JC-Project-IDEA/2025-26-Student-Workshop/Slides/JC Project IDEA - 202526 Software Installation (Windows)-20250909.pdf

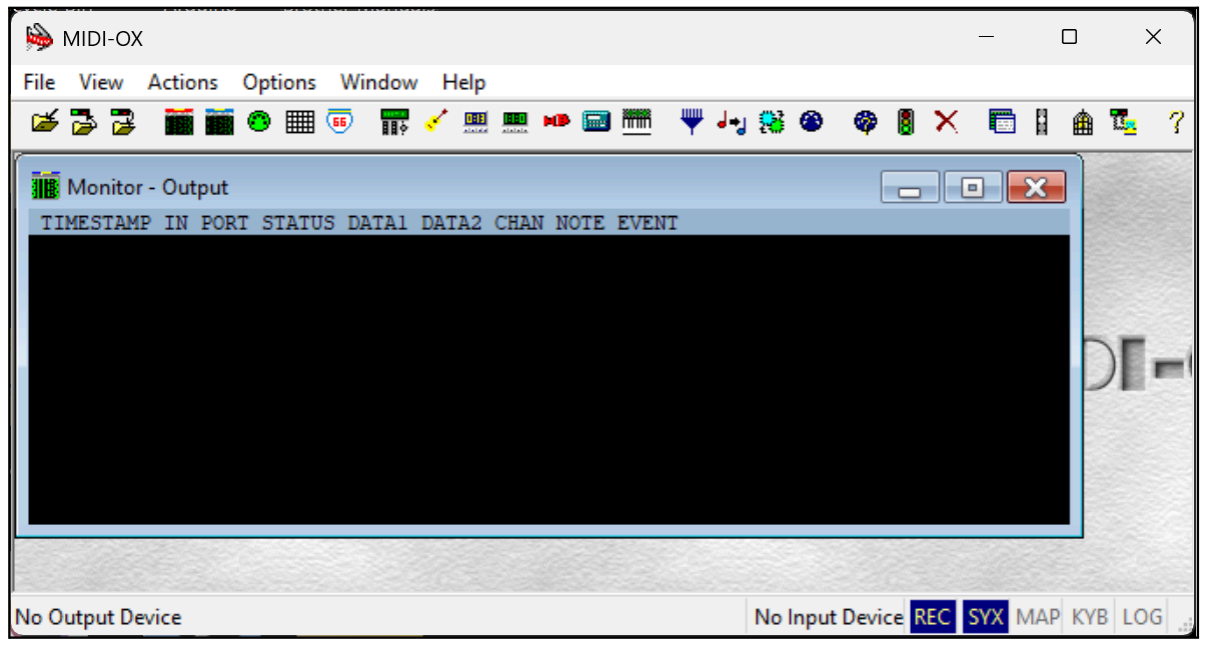
[picture p79: figure]
