JC-Project-IDEA/2025-26-Student-Workshop/Slides/Assembly Guide for Workshops_20251024.pdf

# Jockey Club Project IDEA

# Inclusive Digital and Experimental Art

# 賽馬會科藝共融計劃

# Assembly Guide

### 組裝指南

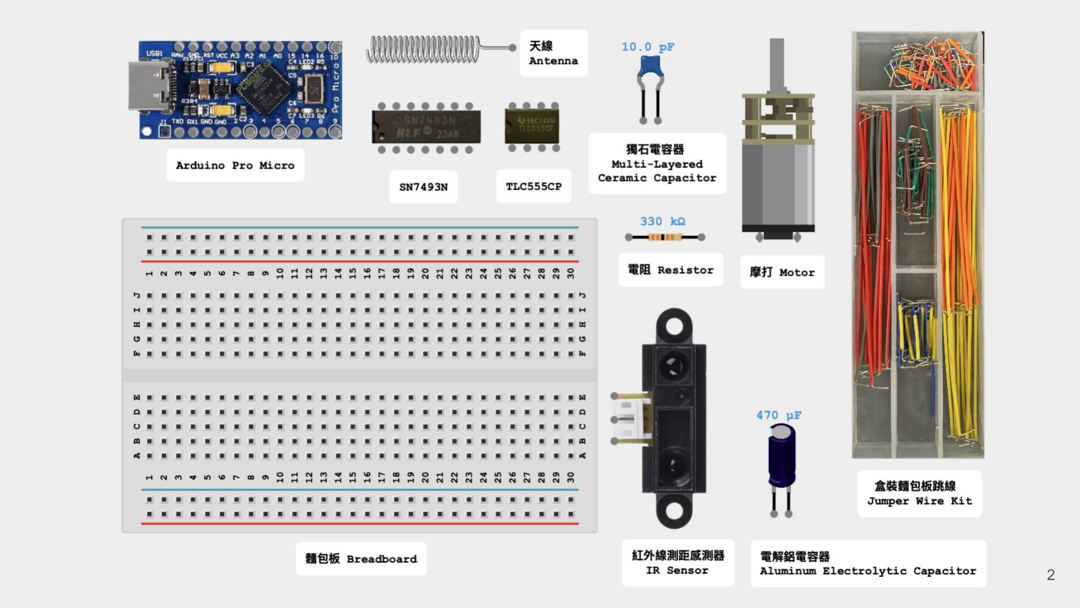
[picture p1: page 2]

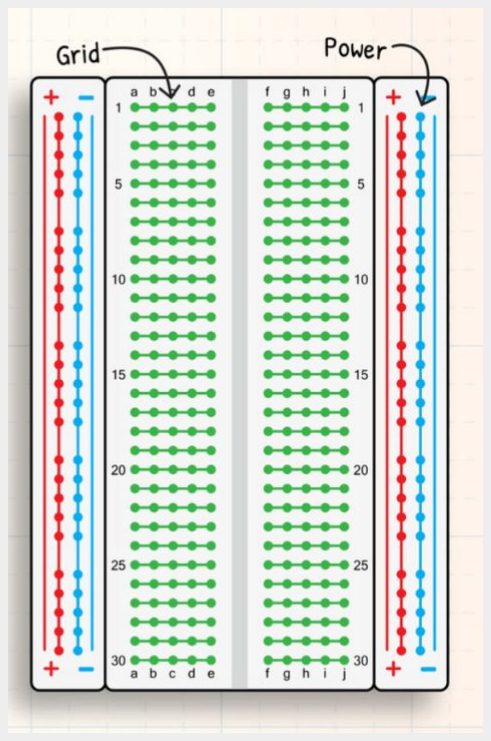
[picture p2: figure]
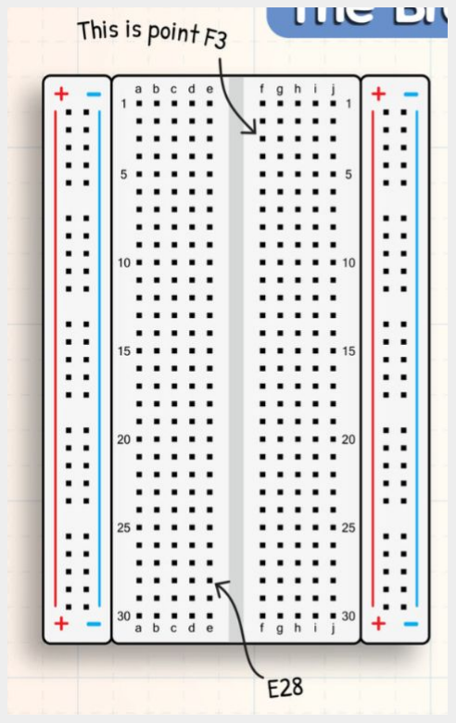
[picture p3: figure]

麵 包 板（ Breadboard）是 一 種 用 於 電 子 電 路 原型設計的免 焊接工具，它允許使用者插入和
拔出電子元件及導線。

麵包板中央的插孔組（通常為每組 5個孔相連）
用於連接電阻、 LED 等電子元件和跳線，以形
成實驗電路。麵包板兩側的兩條長條形插孔（通
常標有「 +」和「 -」紅藍線）用作電源供應，可為整 個電路提供正極和接地。

https://cdn.flipsnack.com/widget/v2/widget.html?hash=hil43imxu3

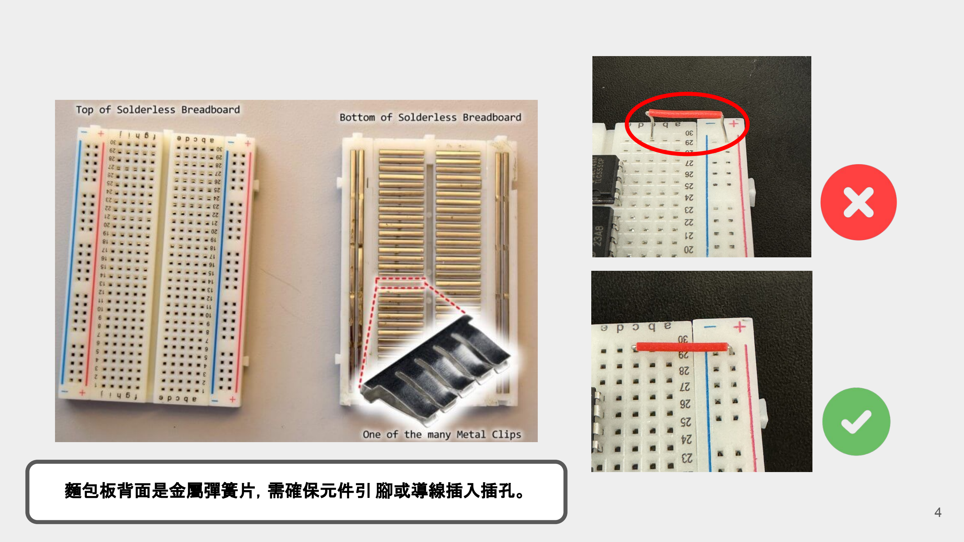
[picture p4: page 4]

麵包板背面是金屬彈簧片，需確保元件引

腳或導線插入插孔。

## 導電五金材料：

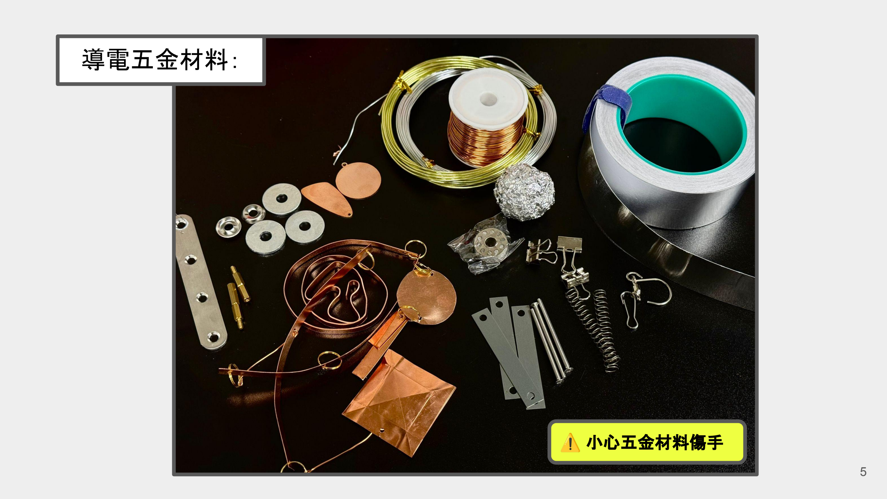
[picture p5: page 5]

⚠ 小心五金材料傷手

# 開始組裝！

# tinyurl.com/SWS2526

## 步驟 1：用跳線連接“正極”和“負極”

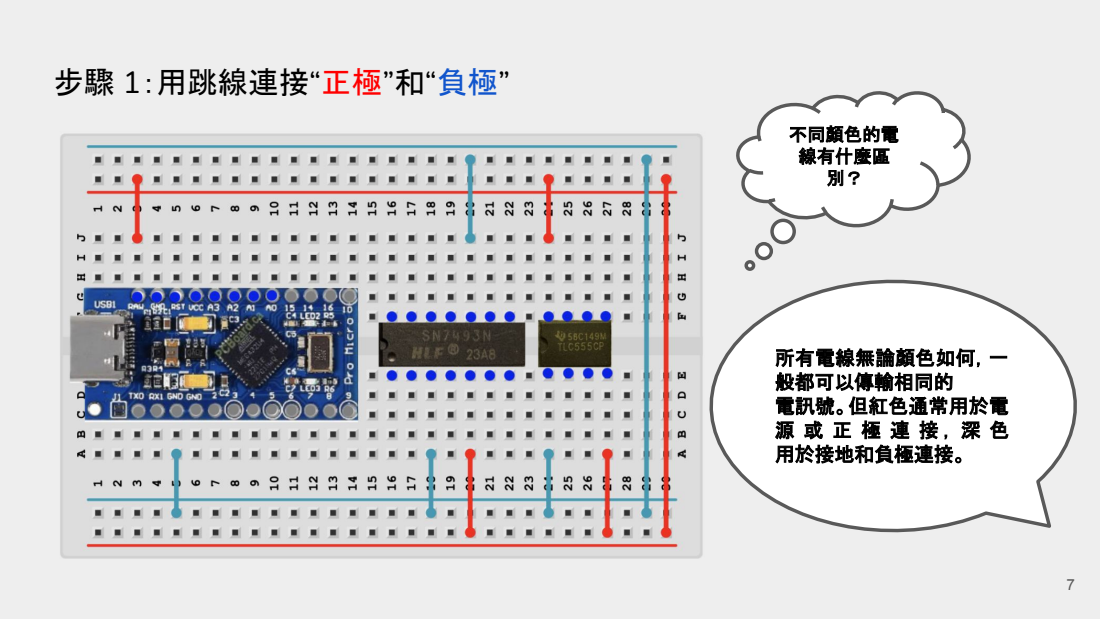
[picture p6: page 7]
不同顏色的電 線有什麼區 別？; 所有電線無論顏色如何，一 般都可以傳輸相同的 電訊號。但紅色通常用於電 源 或 正 極 連 接 ， 深 色 用於接地和負極連接。

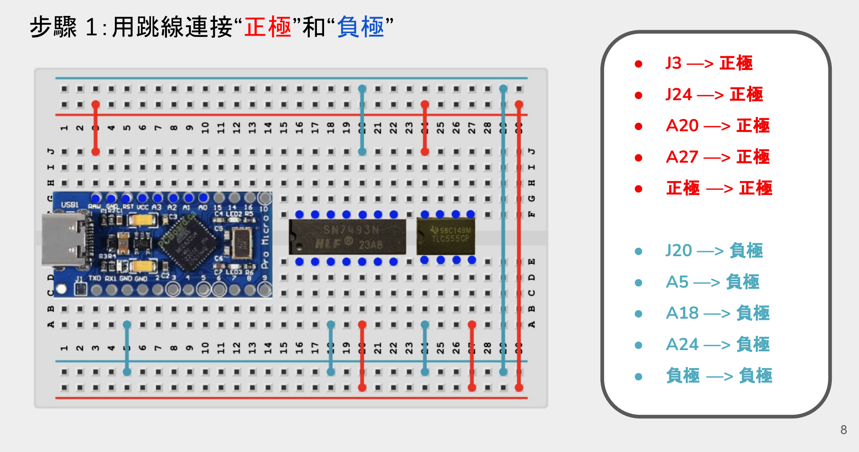
[picture p7: figure]
步驟 1：用跳線連接“正極”和“負極”

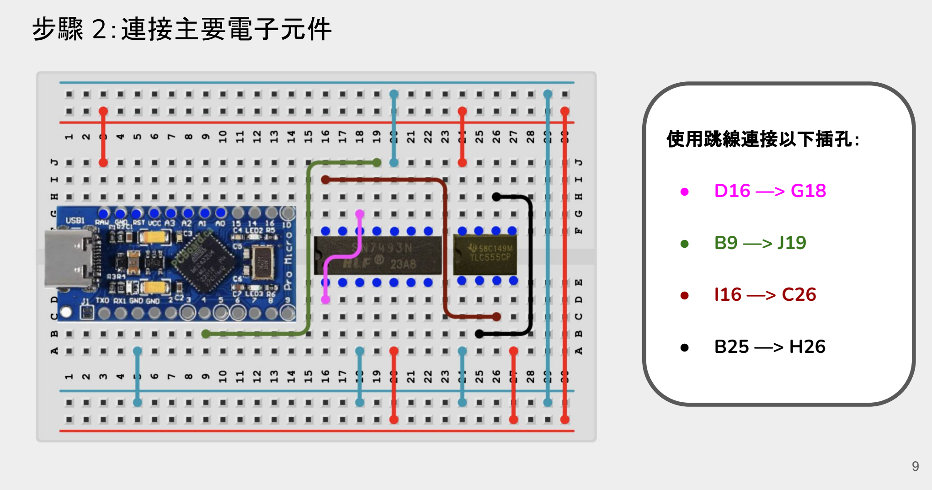
[picture p8: figure]
步驟 2：連接主要電子元件; 使用跳線連接以下插孔：

## 步驟 3：連接電容器、電阻和紅外感測器

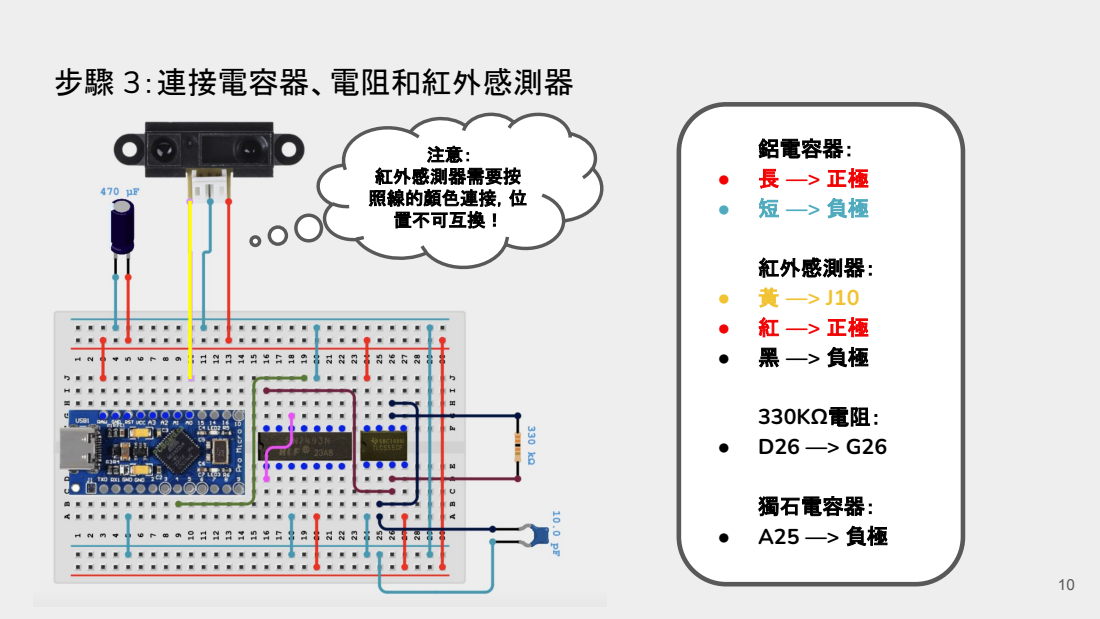
[picture p9: page 10]
鋁電容器： ● 長 —> 正極 ● 短 —> 負極; 紅外感測器： ● 黃 —> J10 ● 紅 —> 正極 ● 黑 —> 負極; 330KΩ電阻： ● D26 —> G26; 獨石電容器： ● A25 —> 負極; 注意： 紅外感測器需要按 照線的顏色連接，位 置不可互換！

## 步驟 3：連接電容器、電阻和紅外感測器

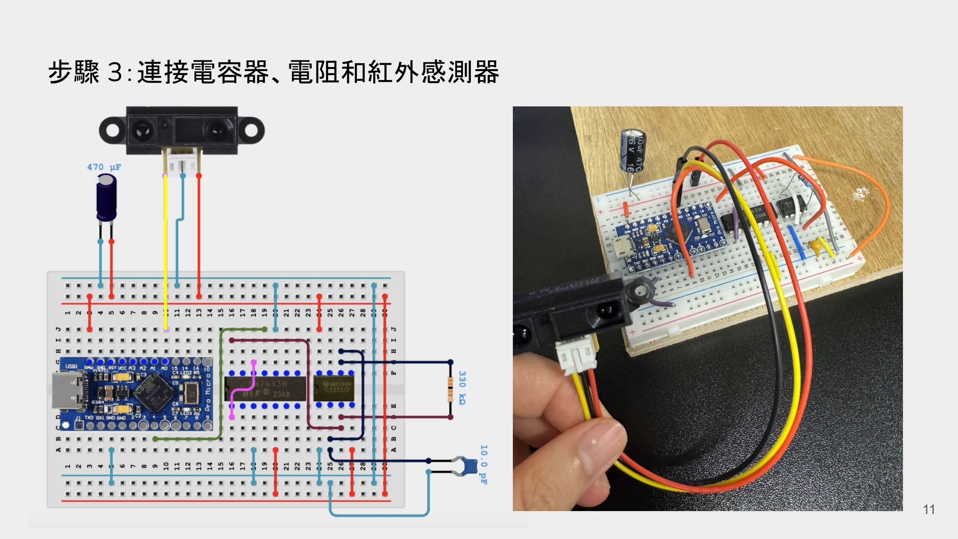
[picture p10: page 11]

## 步驟 4：使用砂紙去除銅線上的絕緣層

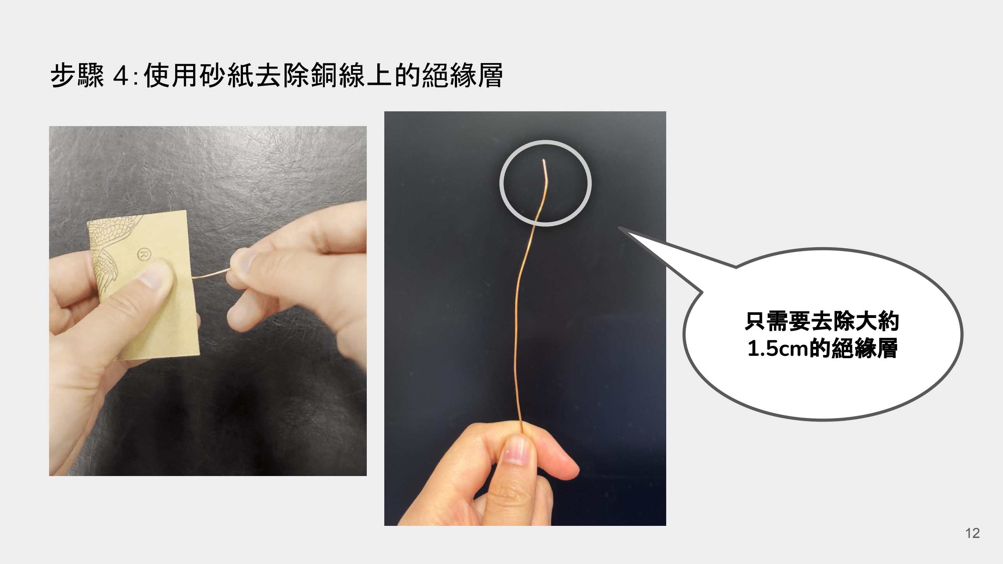
[picture p11: page 12]

只需要去除大約

## 1.5cm的絕緣層

## 步驟 5：將磨好的銅線插入麵包版 J26 位置，作為特雷門琴的天線

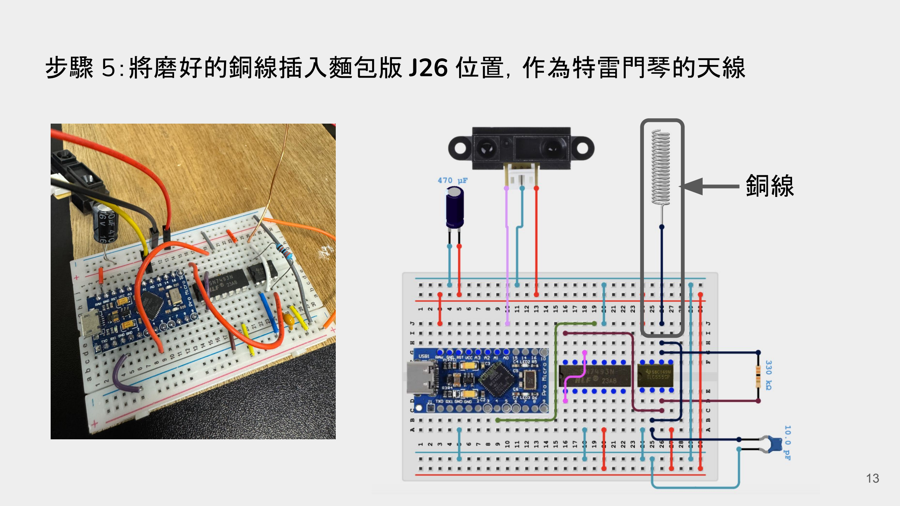
[picture p12: page 13]

銅線

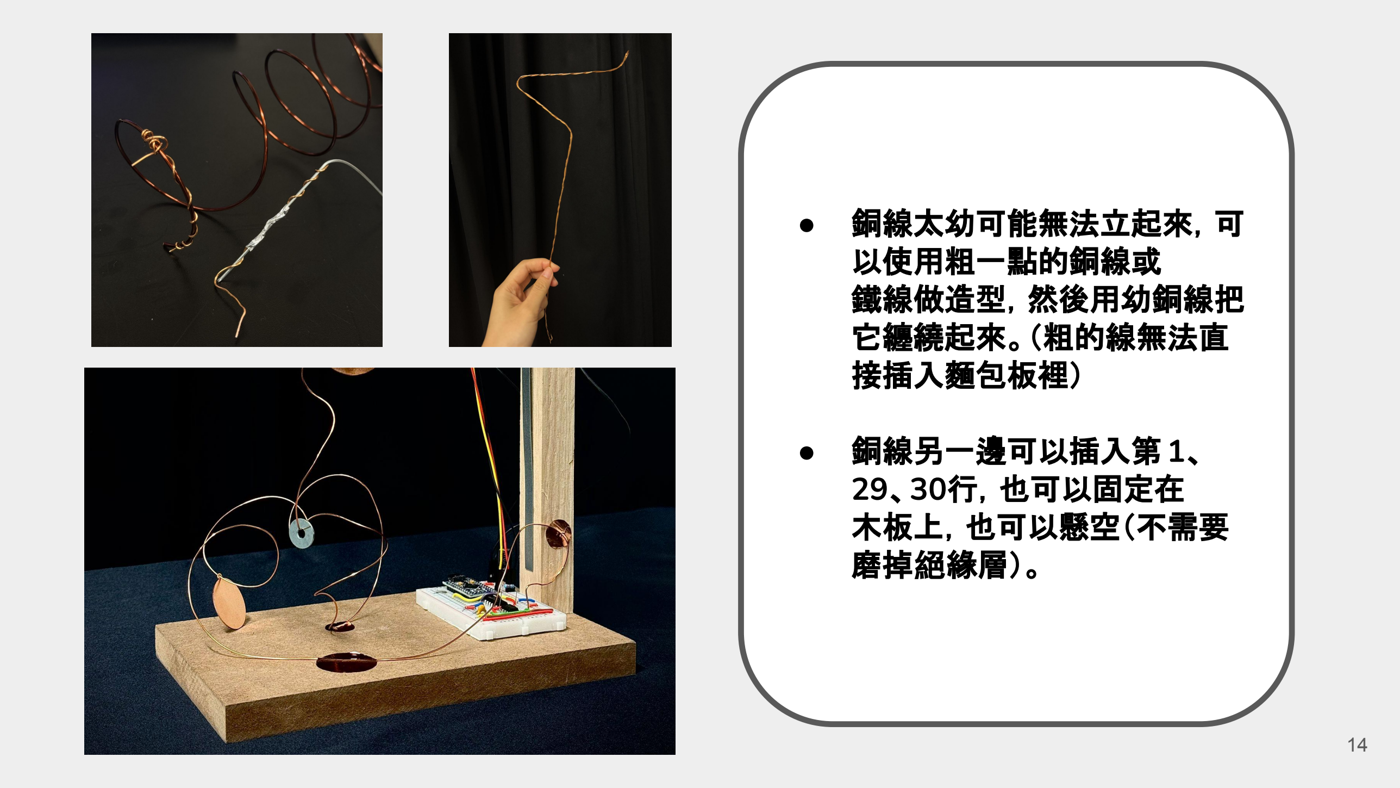
[picture p13: page 14]

- 銅線太幼可能無法立起來，可
以使用粗一點的銅線或
鐵線做造型，然後用幼銅線把
它纏繞起來。（粗的線無法直
接插入麵包板裡）
- 銅線另一邊可以插入第1、
29、30行，也可以固定在
木板上，也可以懸空（不需要
磨掉絕緣層）。

## 步驟 6：連接電腦

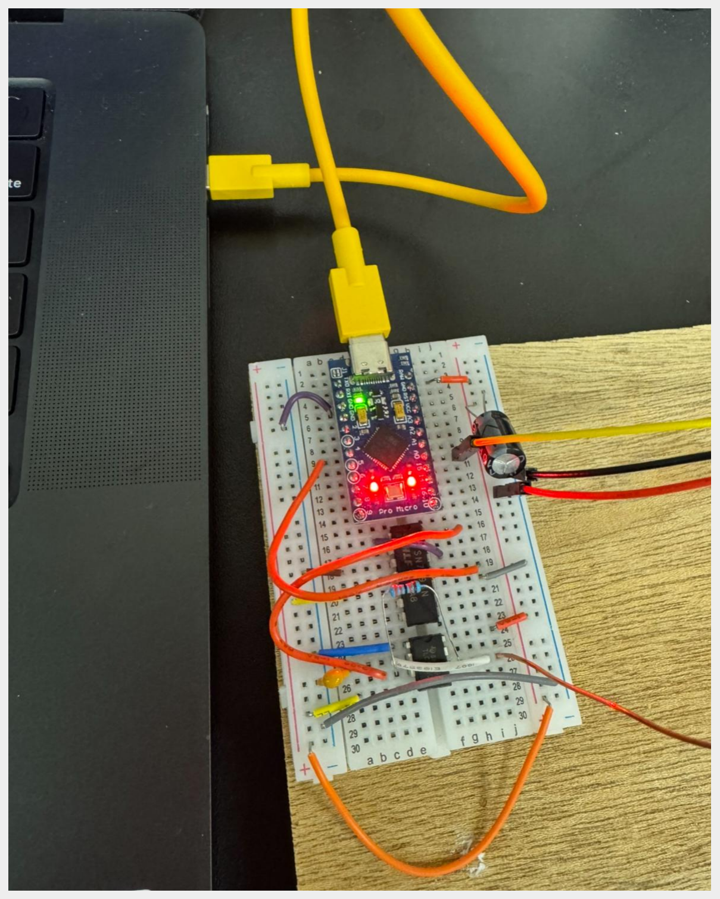
[picture p14: figure]

## 將 Arduino Pro Micro

連接到電腦後，你會看到

## LED 閃爍。

# 完成了基本的組裝， 現在選擇你喜歡的組合：

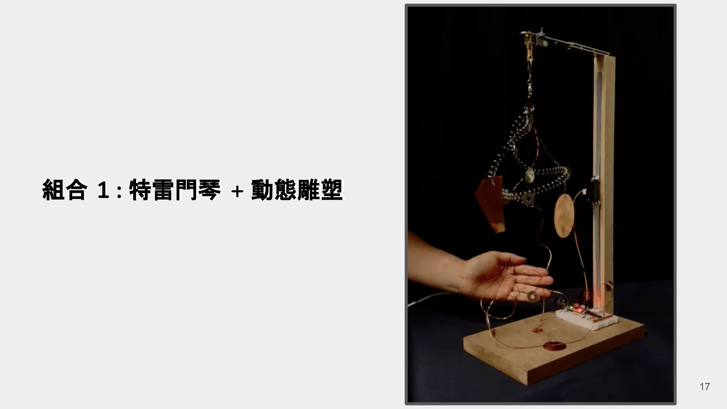
[picture p15: page 17]

## 組合 1 : 特雷門琴 + 動態雕塑

## 用導電的五金材料製作一個抽象風格的雕塑

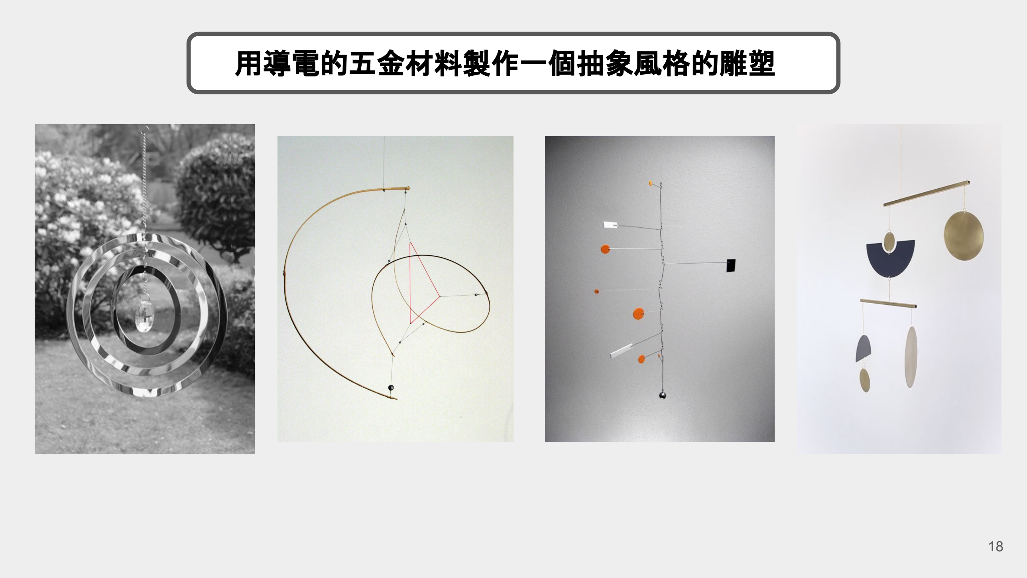
[picture p16: page 18]

## 工具介紹

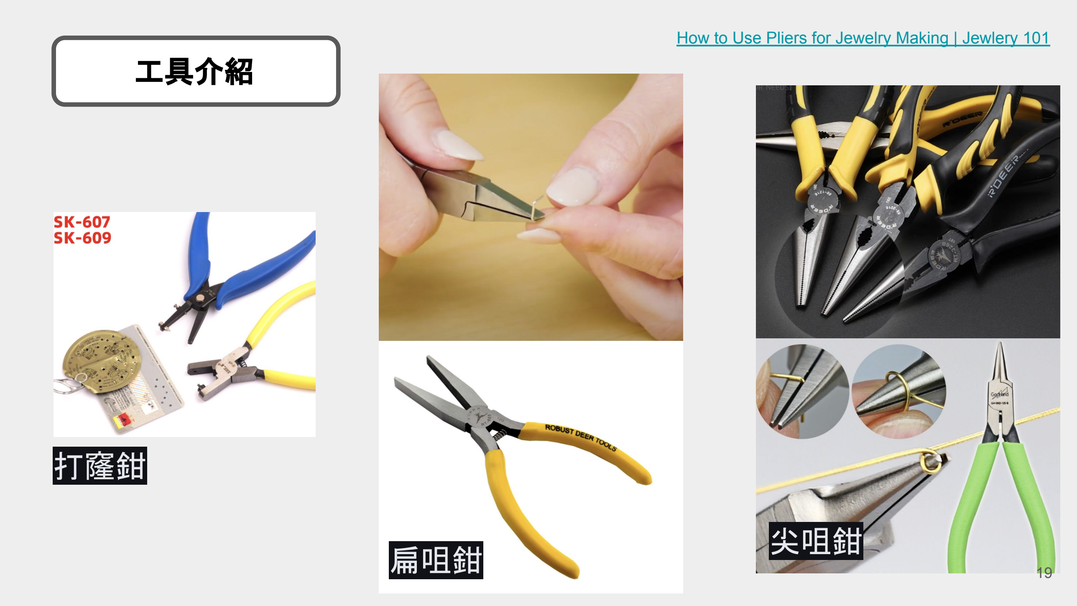
[picture p17: page 19]

扁咀鉗 | 尖咀鉗

## 打窿鉗

How to Use Pliers for Jewelry Making | Jewlery 101 (https://www.youtube.com/watch?v=p0JrrI3PqLI)

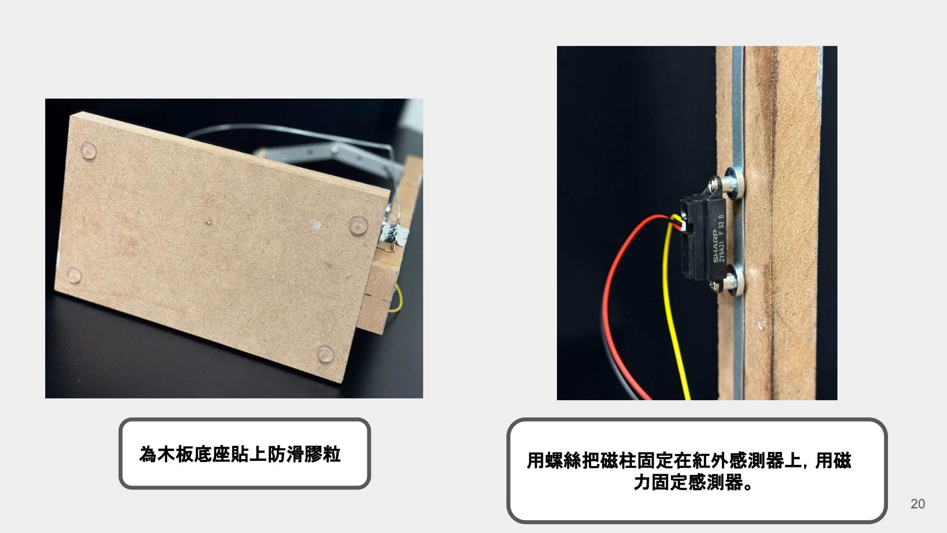
[picture p18: page 20]

為木板底座貼上防滑膠粒 | 用螺絲把磁柱固定在紅外感測器上，用磁 力固定感測器。

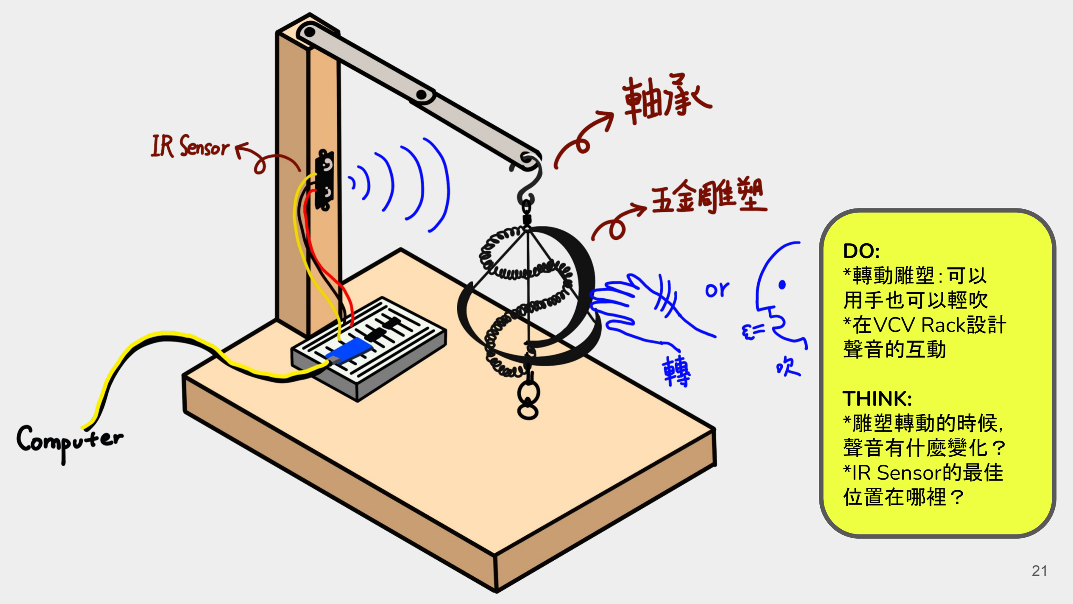
[picture p19: page 21]

DO:
*轉動雕塑：可以
用手也可以輕吹

### *在VCV Rack設計

聲音的互動

### THINK:

*雕塑轉動的時候，
聲音有什麼變化？

### *IR Sensor的最佳

位置在哪裡？

鎖緊聯軸器 | 連接摩打到麵包板的正負極

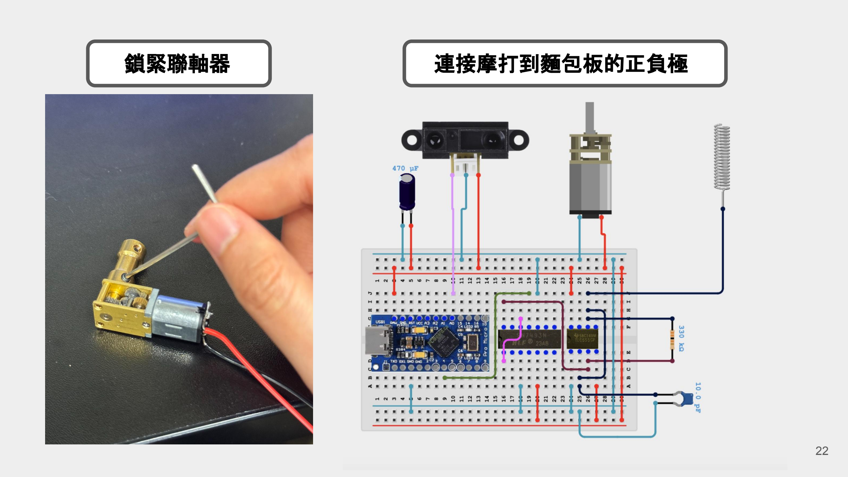
[picture p20: page 22]
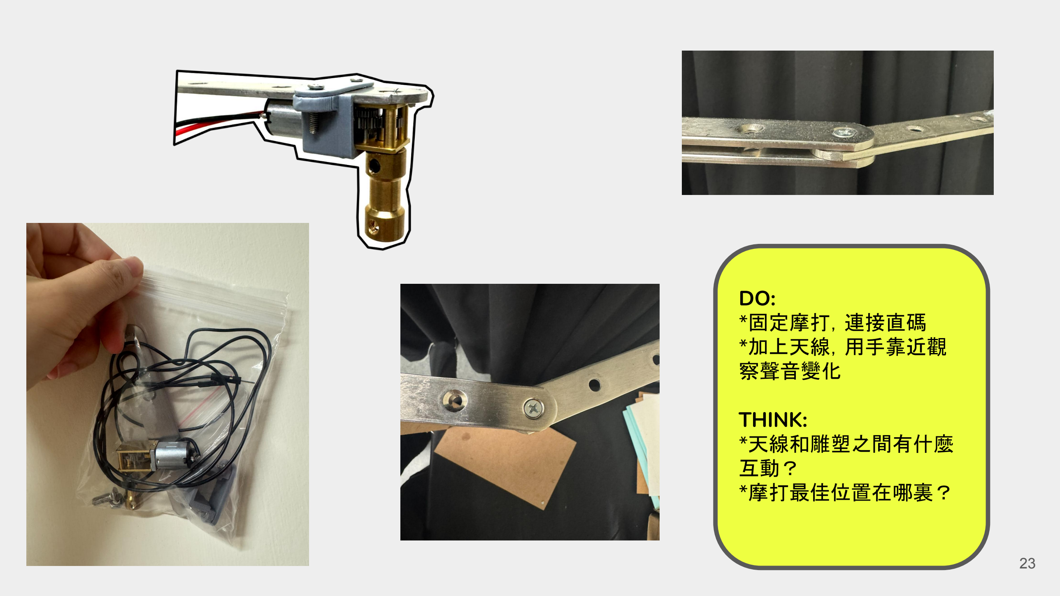
[picture p21: page 23]

DO:
*固定摩打，連接直碼
*加上天線，用手靠近觀
察聲音變化

### THINK:

*天線和雕塑之間有什麼
互動？
*摩打最佳位置在哪裏？

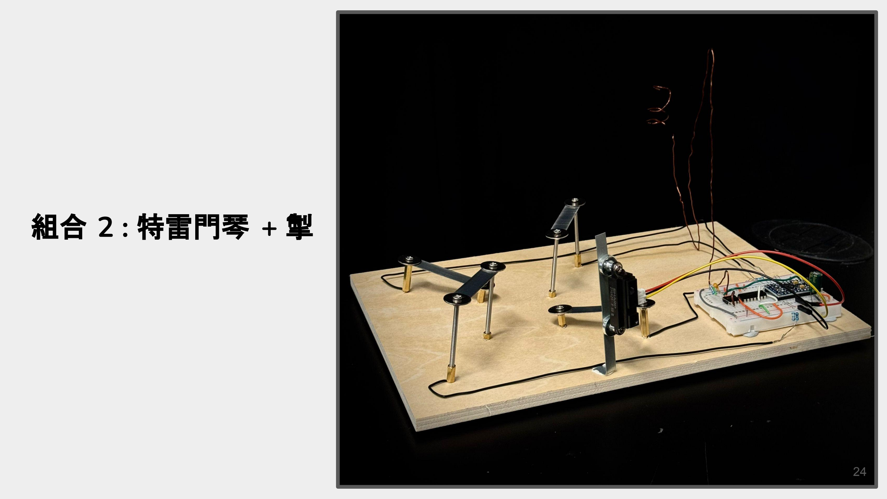
[picture p22: page 24]

## 組合 2 : 特雷門琴 + 掣

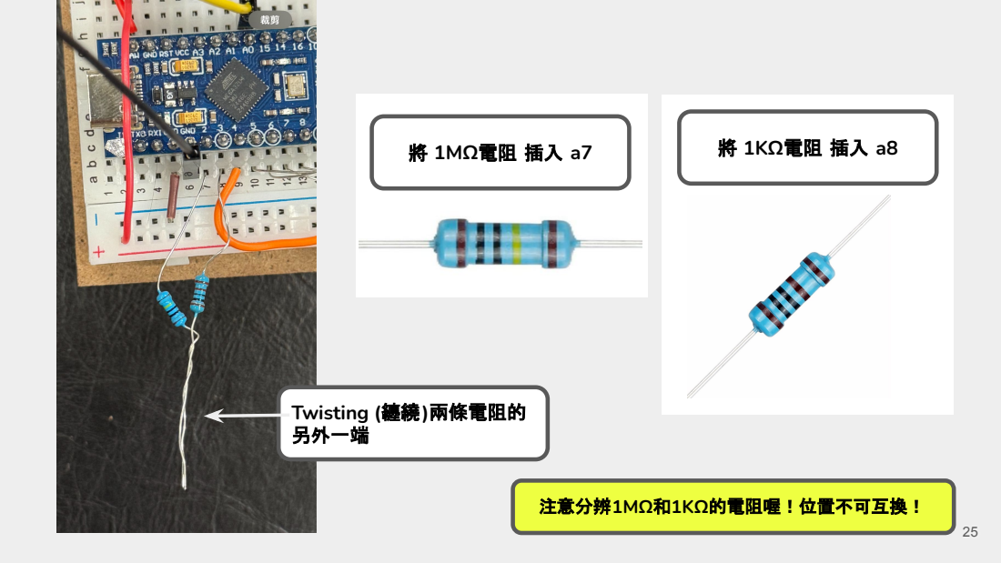
[picture p23: page 25]
將 1MΩ電阻 插入 a7; 將 1KΩ電阻 插入 a8; 注意分辨1MΩ和1KΩ的電阻喔！位置不可互換！

Twisting (纏繞)兩條電阻的
另外一端

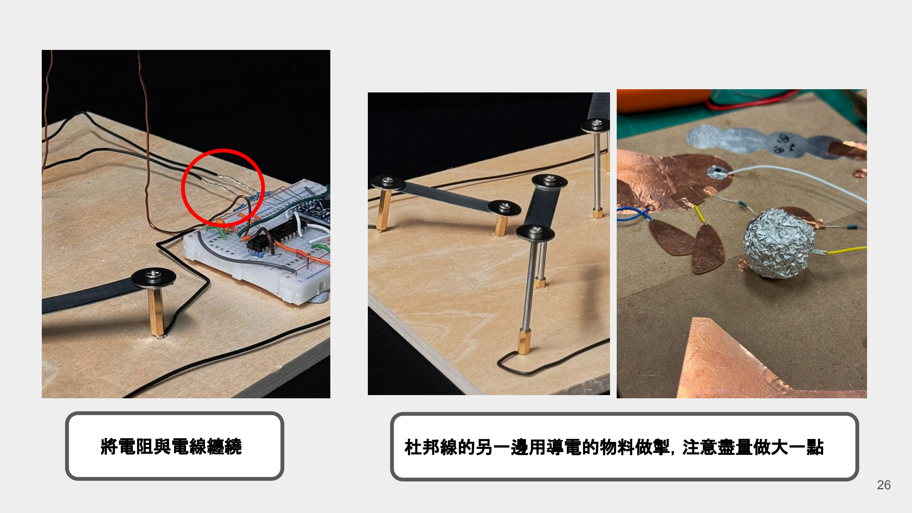
[picture p24: page 26]

將電阻與電線纏繞 | 杜邦線的另一邊用導電的物料做掣，注意盡量做大一點

### Button 1： - 1MΩ —> A7

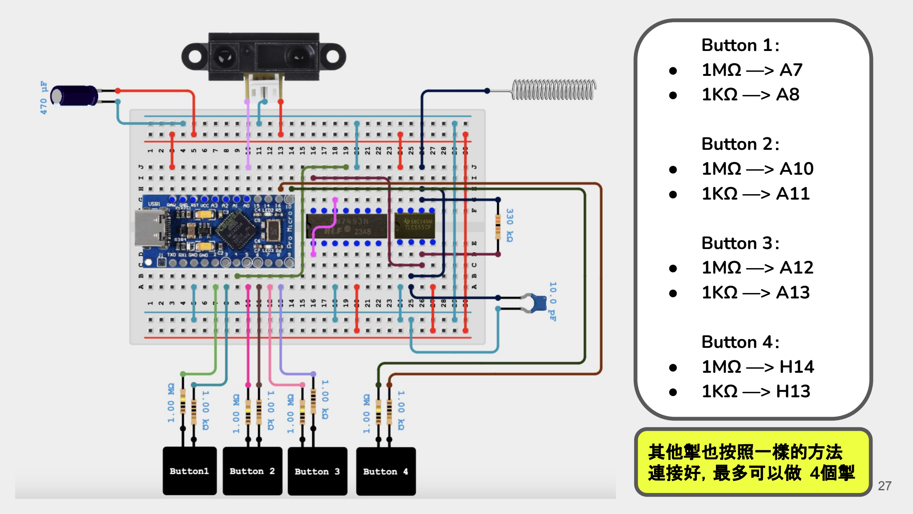
[picture p25: page 27]

其他掣也按照一樣的方法
連接好，最多可以做 4個掣

### - 1KΩ —> A8

### Button 2： - 1MΩ —> A10 - 1KΩ —> A11

### Button 3： - 1MΩ —> A12 - 1KΩ —> A13

### Button 4： - 1MΩ —> H14 - 1KΩ —> H13

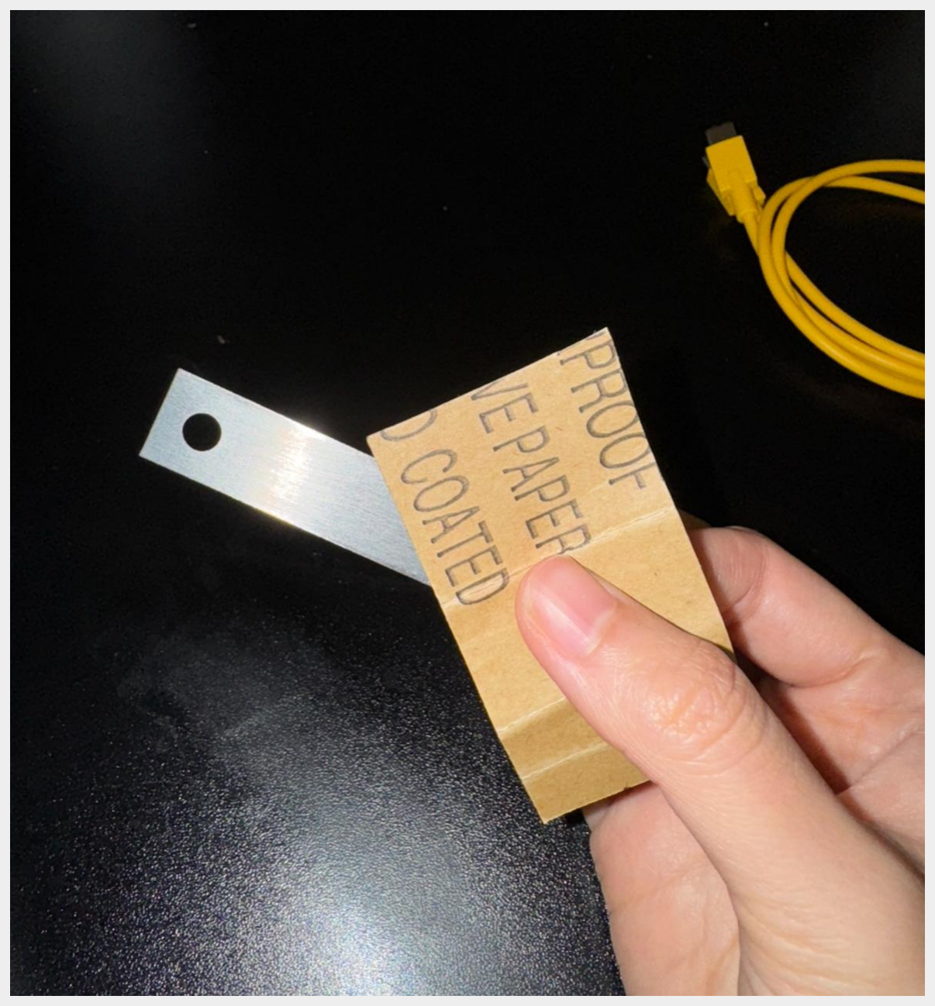
[picture p26: figure]

如果要用短鐵片，需要用
砂紙磨去

絕緣層
