JC-Project-IDEA/2025-26-Student-Workshop/Slides/Assembly Guide for Workshops_20251024_forPrint.pdf

# Jockey Club Project IDEA

# Inclusive Digital and Experimental Art

# 賽馬會科藝共融計劃

# Assembly Guide

### 組裝指南

1

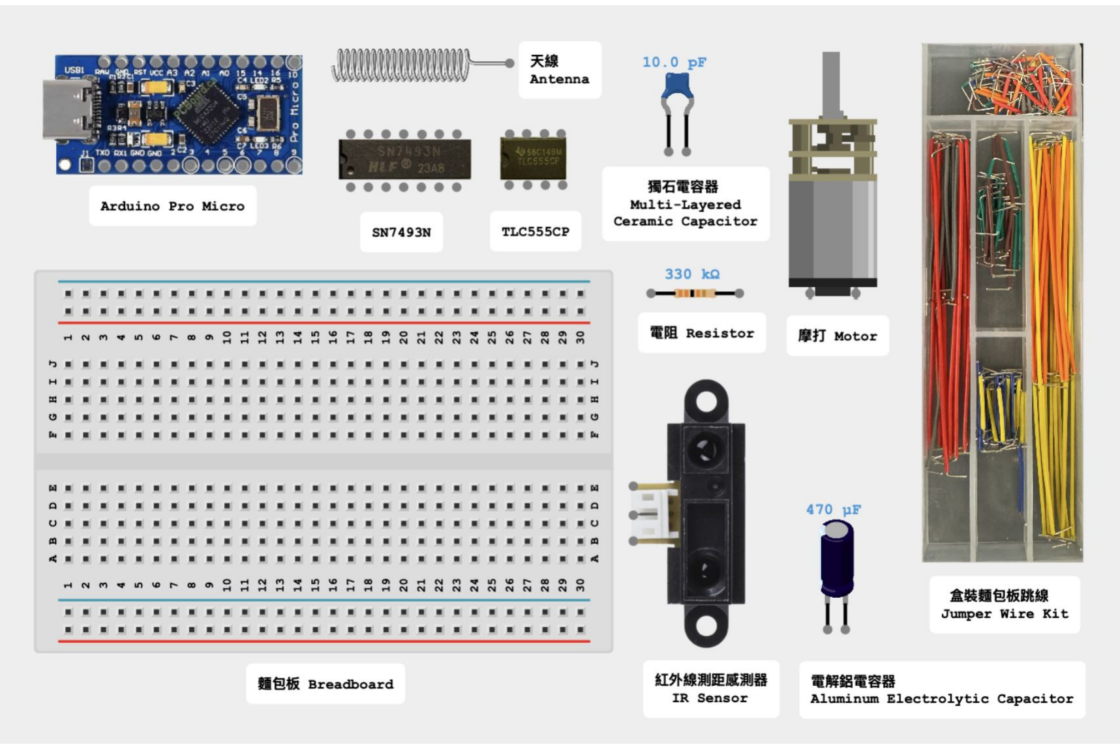
[picture p27: figure]

2

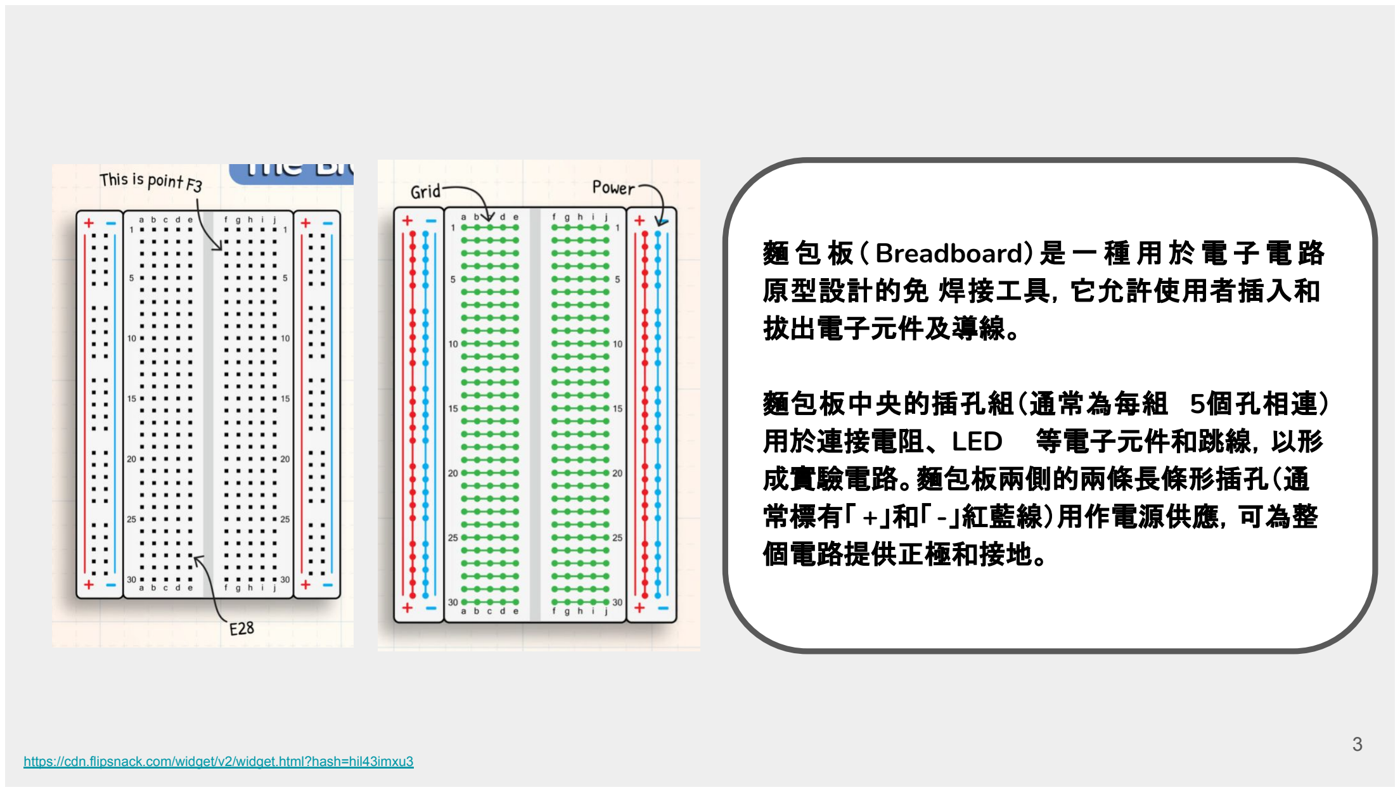
[picture p28: figure]
麵包板（ Breadboard）是一種用於電子電路; 原型設計的免 焊接工具，它允許使用者插入和 拔出電子元件及導線。; 麵包板中央的插孔組（通常為每組 5個孔相連） 用於連接電阻、 LED 等電子元件和跳線，以形; 成實驗電路。麵包板兩側的兩條長條形插孔（通 常標有「 +」和「 -」紅藍線）用作電源供應，可為整; 個電路提供正極和接地。; https://cdn.flipsnack.com/widget/v2/widget.html?hash=hil43imxu3
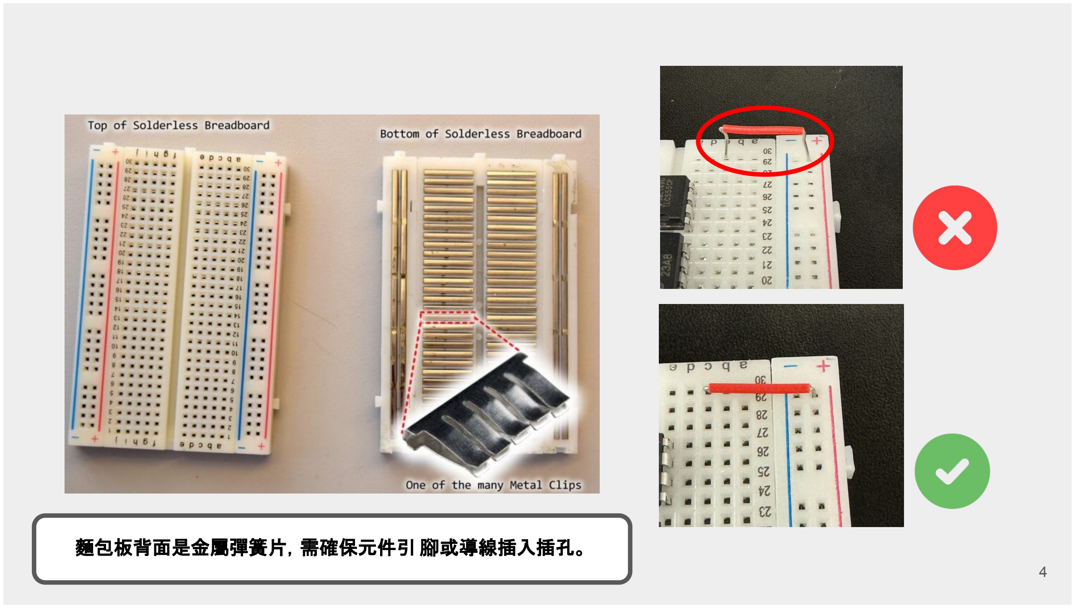
[picture p29: figure]
麵包板背面是金屬彈簧片，需確保元件引 腳或導線插入插孔。

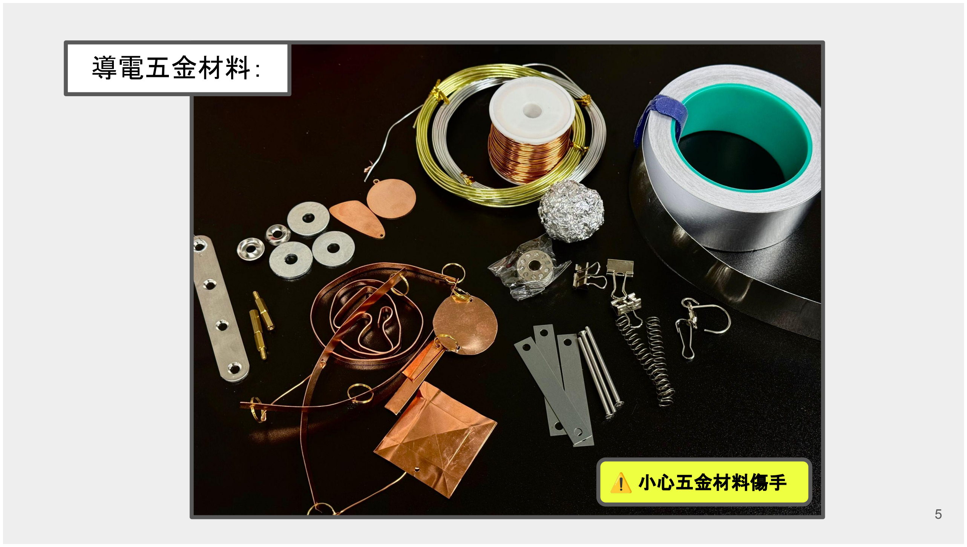
[picture p30: figure]
導電五金材料：; ⚠ 小心五金材料傷手

# 開始組裝！

6

# tinyurl.com/SWS2526

## 步驟 1：用跳線連接“正極”和“負極”

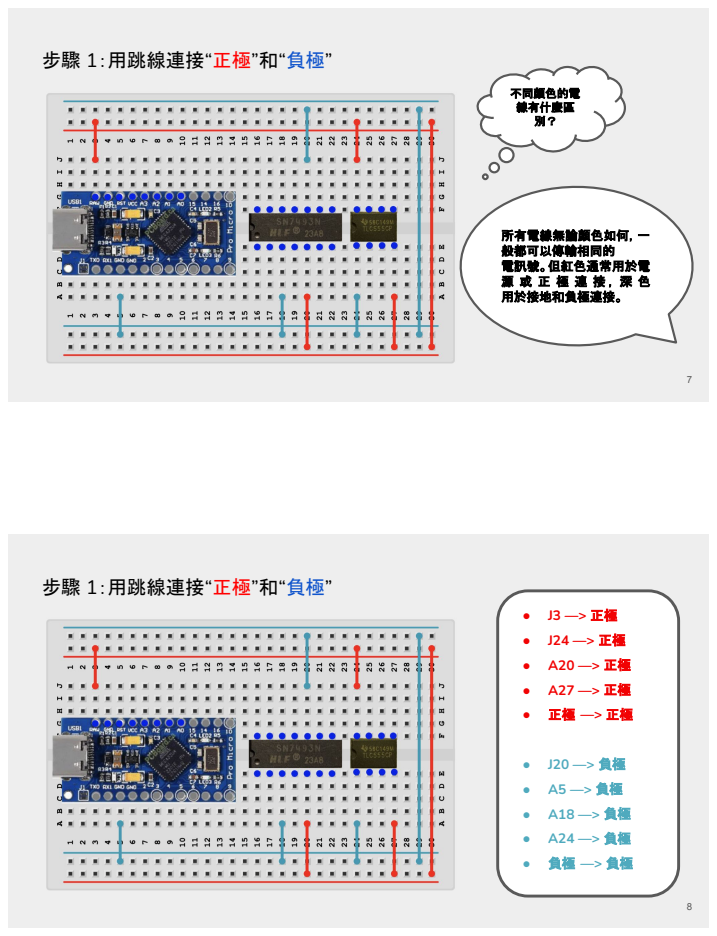
[picture p31: page 4]
不同顏色的電 線有什麼區 別？; 所有電線無論顏色如何，一 般都可以傳輸相同的 電訊號。但紅色通常用於電 源 或 正 極 連 接，深 色 用於接地和負極連接。

步驟 1：用跳線連接“正極”和“負極”

## 步驟 2：連接主要電子元件

- D16 —> G18

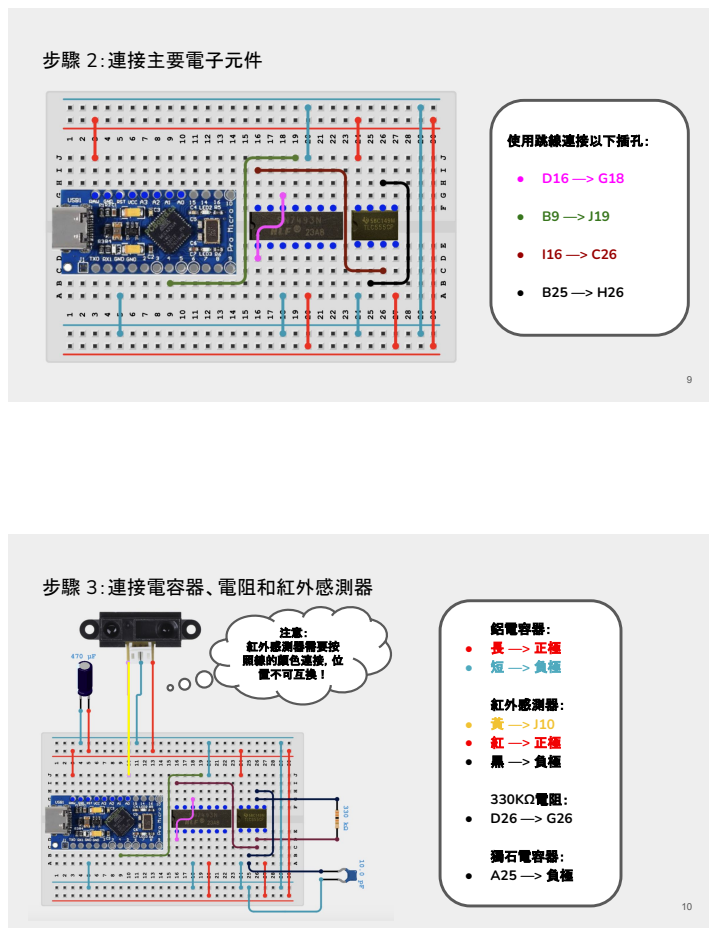
[picture p32: page 5]
使用跳線連接以下插孔：; 鋁電容器： ● 長 —> 正極 ● 短 —> 負極; 紅外感測器： ● 黃 —> J10 ● 紅 —> 正極 ● 黑 —> 負極; 330KΩ電阻： ● D26 —> G26; 獨石電容器： ● A25 —> 負極; 注意： 紅外感測器需要按 照線的顏色連接，位 置不可互換！

步驟 3：連接電容器、電阻和紅外感測器

## 步驟 3：連接電容器、電阻和紅外感測器

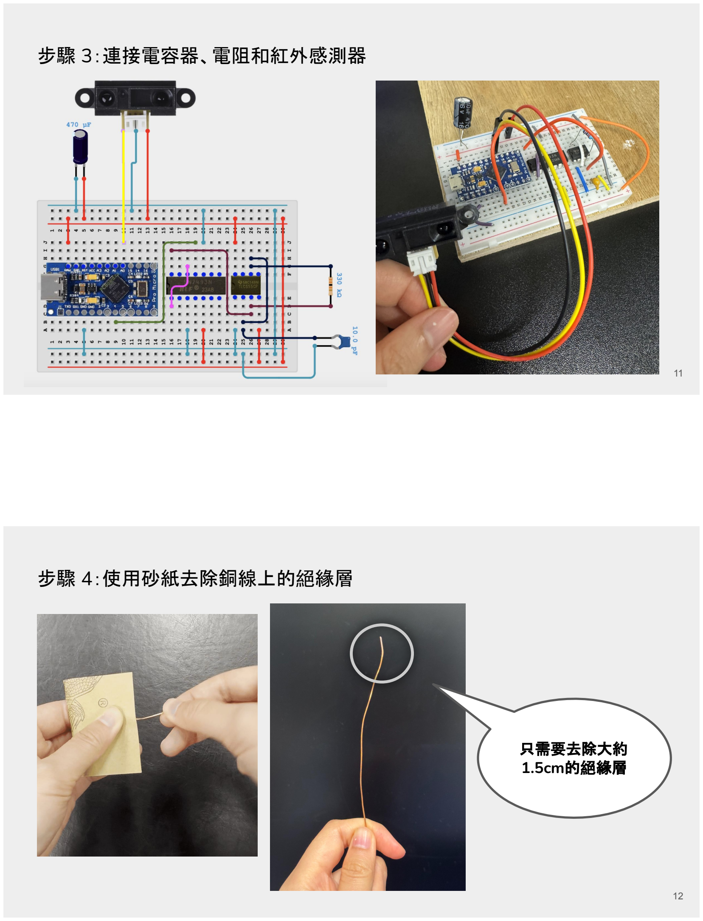
[picture p33: page 6]

11

## 步驟 4：使用砂紙去除銅線上的絕緣層

只需要去除大約

## 1.5cm的絕緣層

12

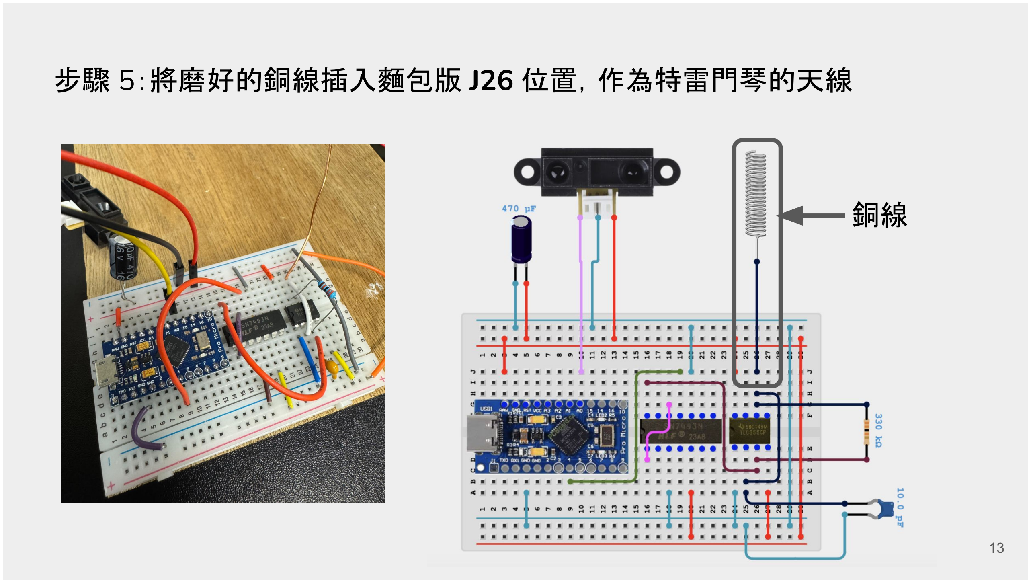
[picture p34: figure]
步驟 5：將磨好的銅線插入麵包版 J26 位置，作為特雷門琴的天線
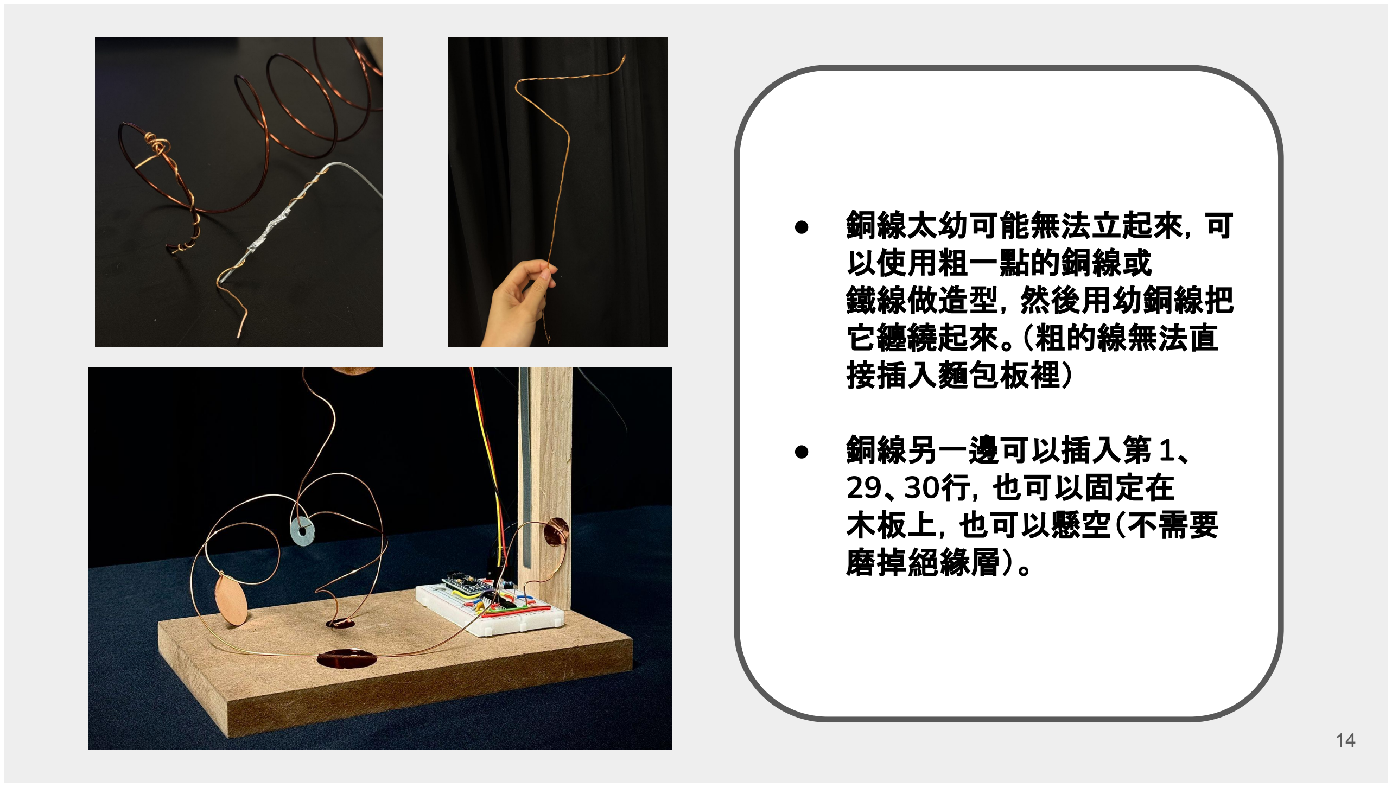
[picture p35: figure]
● 銅線太幼可能無法立起來，可 以使用粗一點的銅線或 鐵線做造型，然後用幼銅線把 它纏繞起來。（粗的線無法直 接插入麵包板裡）; ● 銅線另一邊可以插入第1、 29、30行，也可以固定在 木板上，也可以懸空（不需要 磨掉絕緣層）。

## 步驟 6：連接電腦

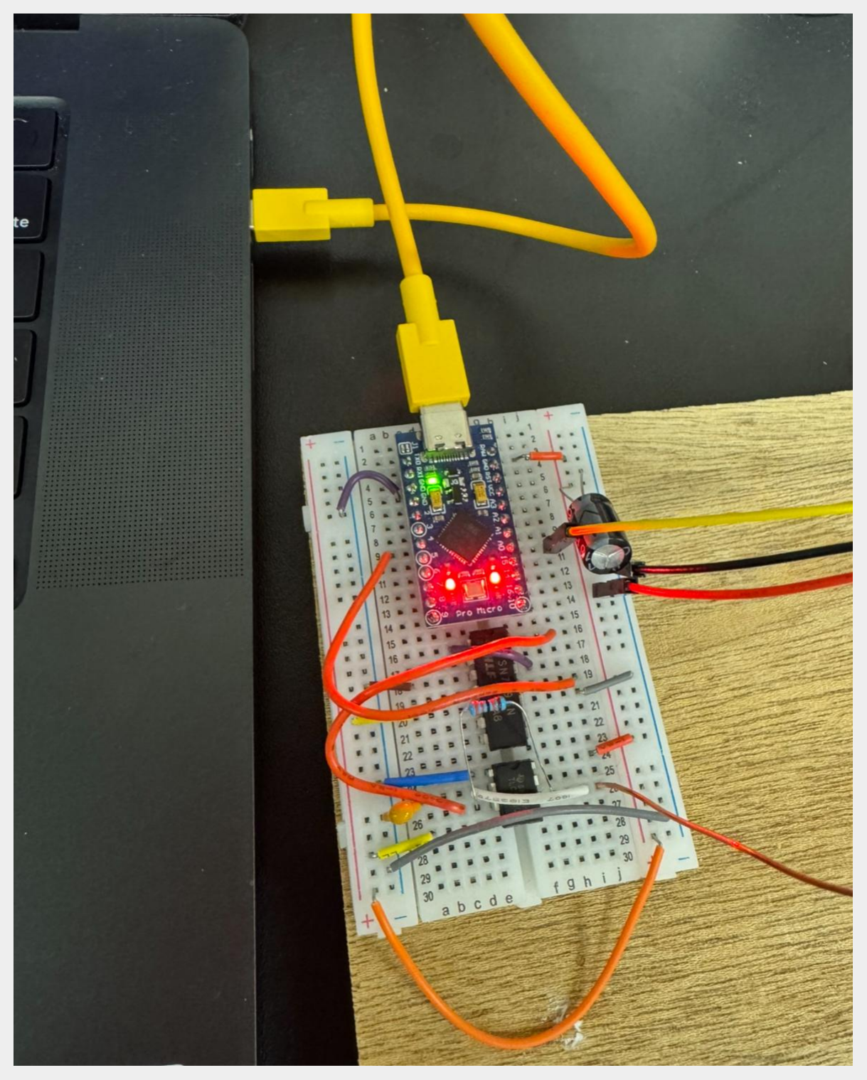
[picture p36: figure]

## 將 Arduino Pro Micro

連接到電腦後，你會看到

## LED 閃爍。

15

# 完成了基本的組裝， 現在選擇你喜歡的組合：

16

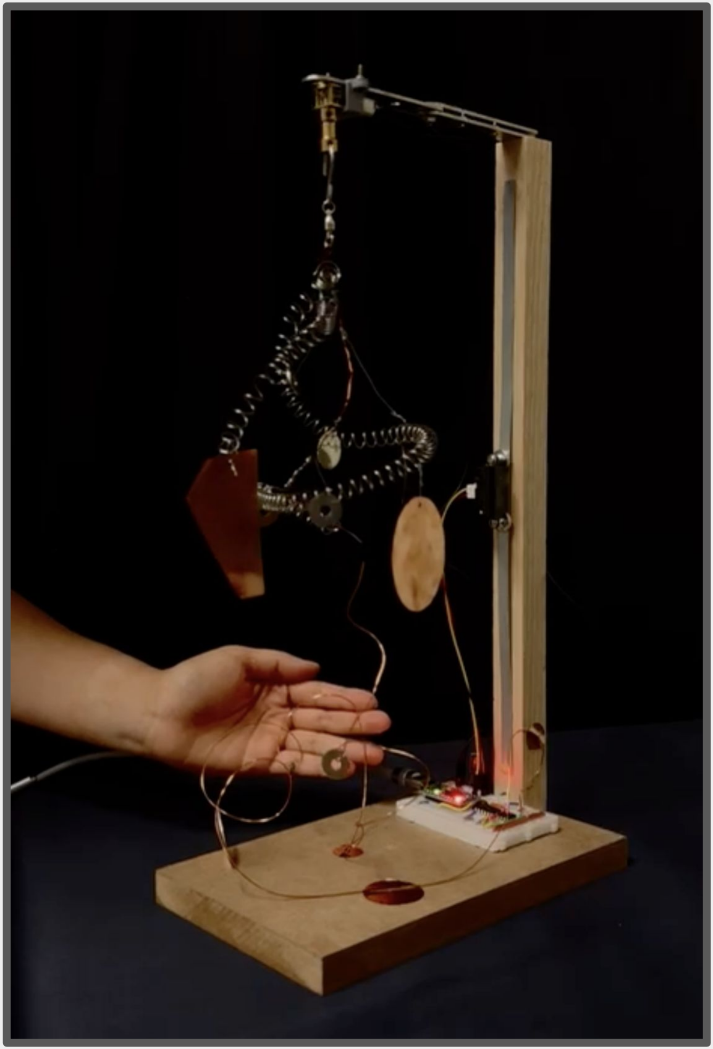
[picture p37: figure]

17

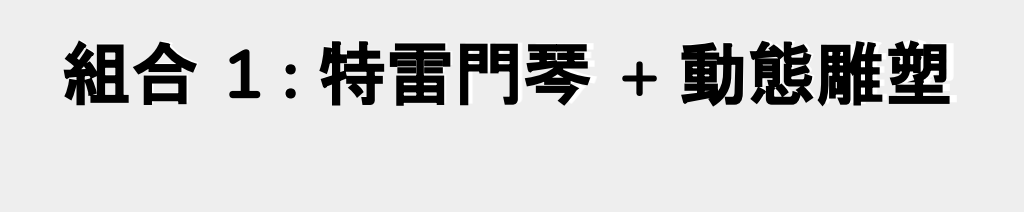
[picture p38: figure]
組合 1 : 特雷門琴 + 動態雕塑
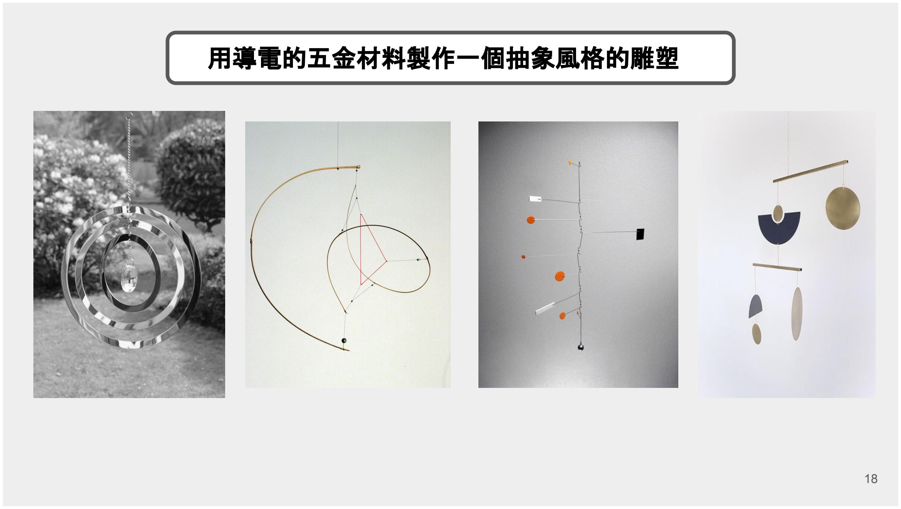
[picture p39: figure]
用導電的五金材料製作一個抽象風格的雕塑

## 工具介紹

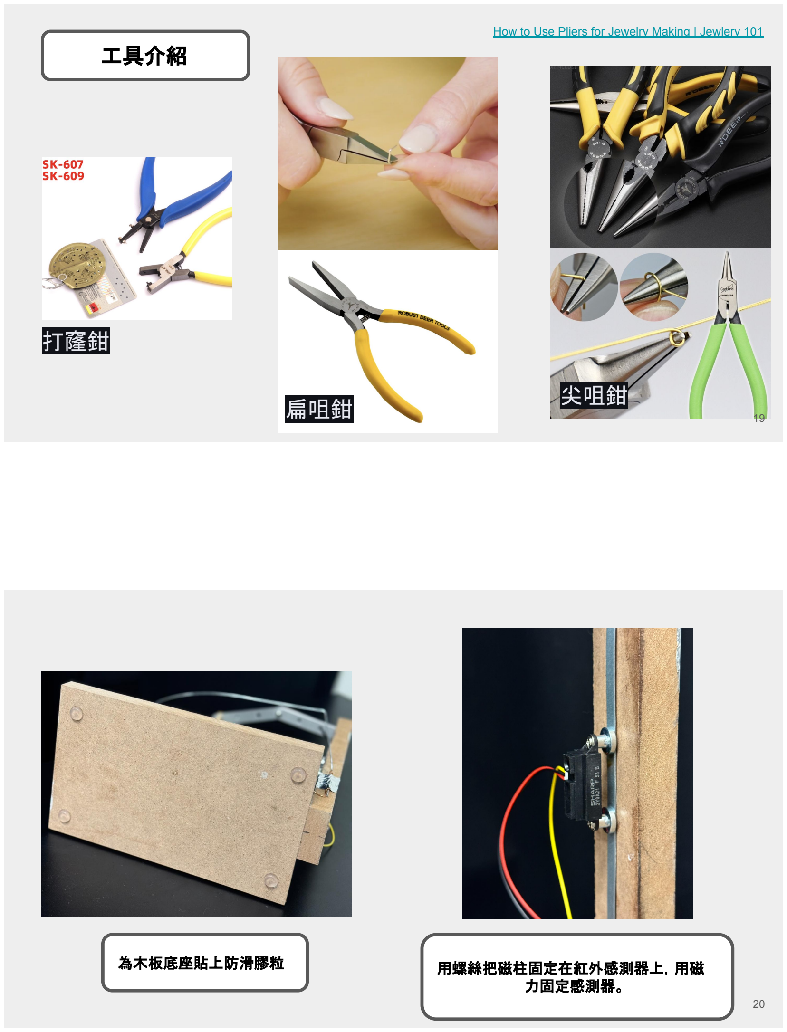
[picture p40: page 10]

扁咀鉗 | 尖咀鉗

## 打窿鉗

How to Use Pliers for Jewelry Making | Jewlery 101

19

為木板底座貼上防滑膠粒 | 用螺絲把磁柱固定在紅外感測器上，用磁 力固定感測器。

20

DO:

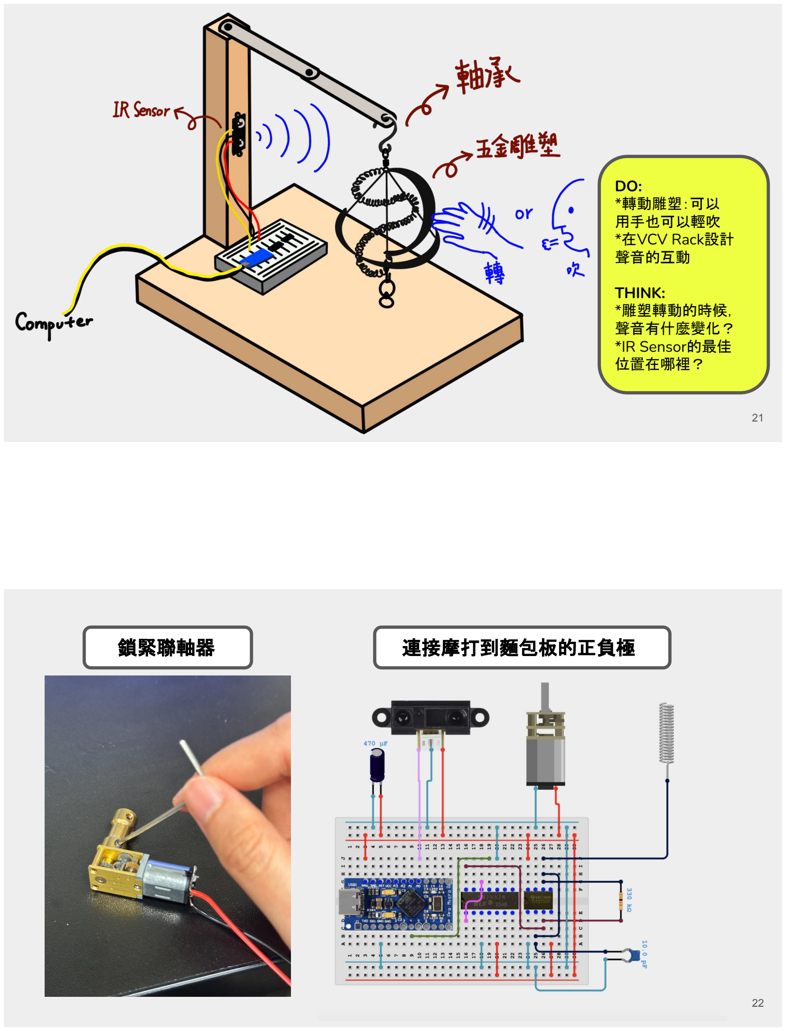
[picture p41: page 11]

*轉動雕塑：可以
用手也可以輕吹

### *在VCV Rack設計

聲音的互動

### THINK:

*雕塑轉動的時候，
聲音有什麼變化？

### *IR Sensor的最佳

位置在哪裡？

21

鎖緊聯軸器 | 連接摩打到麵包板的正負極

22

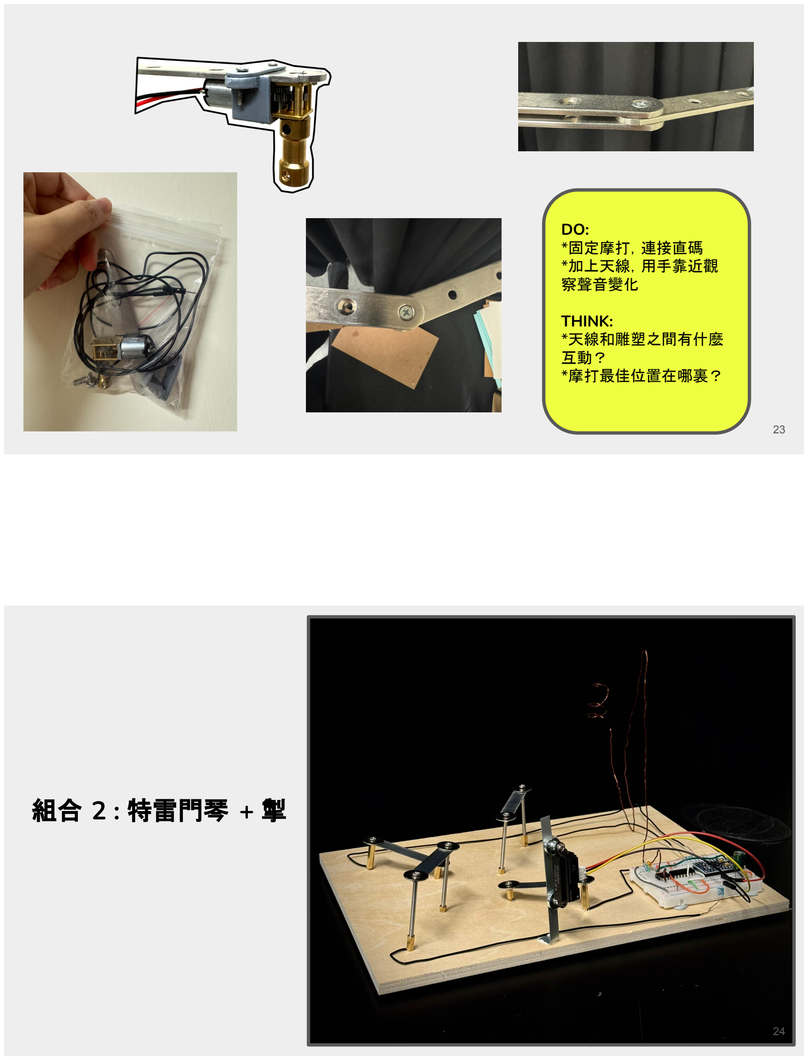
[picture p42: page 12]

DO:
*固定摩打，連接直碼
*加上天線，用手靠近觀
察聲音變化

### THINK:

*天線和雕塑之間有什麼
互動？
*摩打最佳位置在哪裏？

23

## 組合 2 : 特雷門琴 + 掣

24

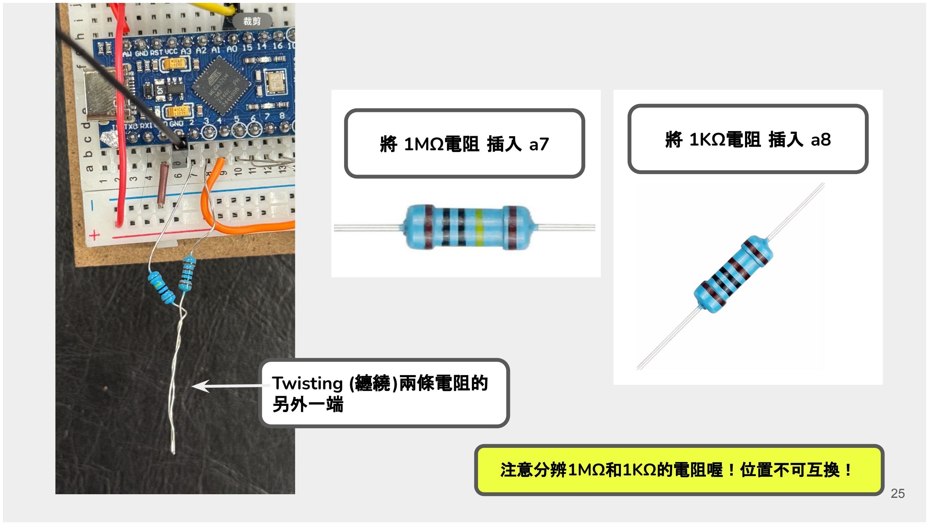
[picture p43: figure]
將 1MΩ電阻 插入 a7; 將 1KΩ電阻 插入 a8; Twisting (纏繞)兩條電阻的 另外一端; 注意分辨1MΩ和1KΩ的電阻喔！位置不可互換！
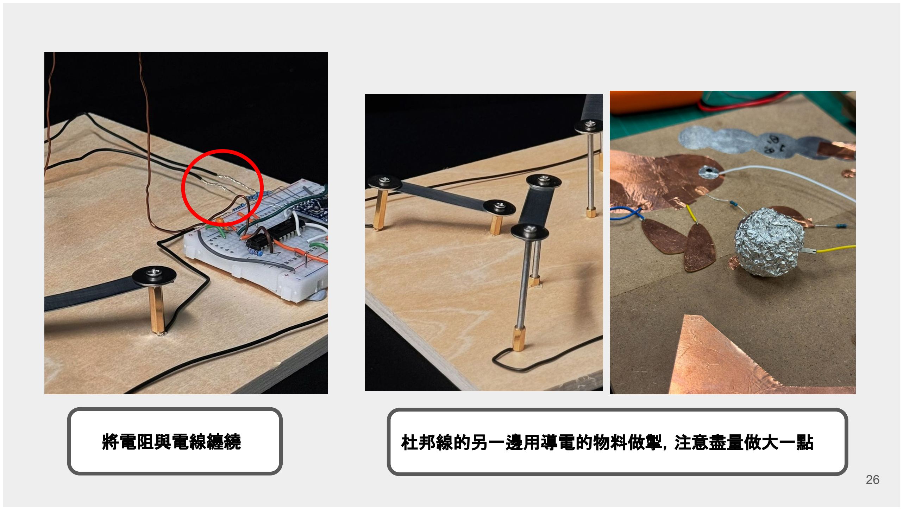
[picture p44: figure]
將電阻與電線纏繞; 杜邦線的另一邊用導電的物料做掣，注意盡量做大一點

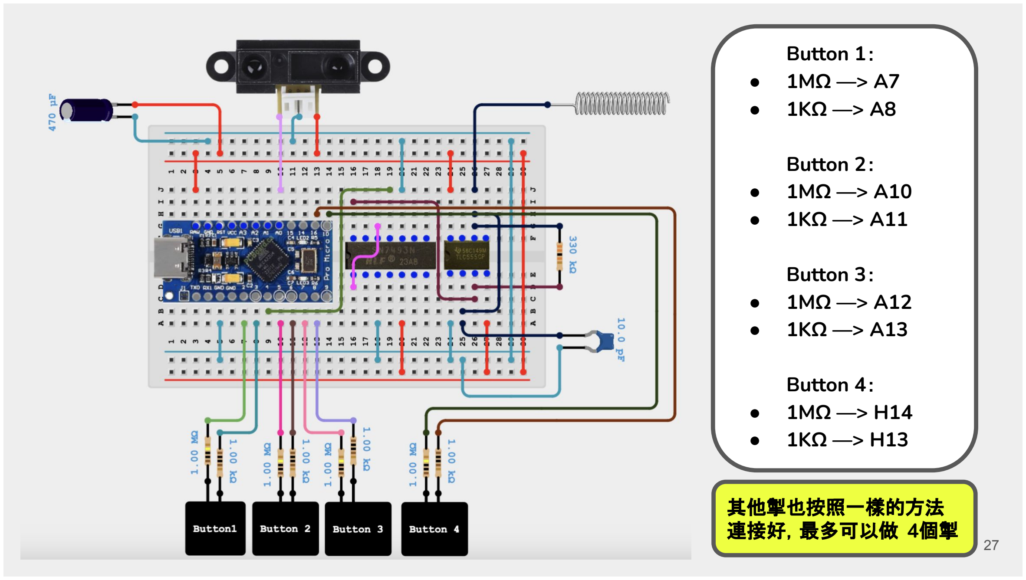
[picture p45: figure]
其他掣也按照一樣的方法 連接好，最多可以做 4個掣; Button 1： ● 1MΩ —> A7 ● 1KΩ —> A8; Button 2： ● 1MΩ —> A10 ● 1KΩ —> A11; Button 3： ● 1MΩ —> A12 ● 1KΩ —> A13; Button 4： ● 1MΩ —> H14 ● 1KΩ —> H13
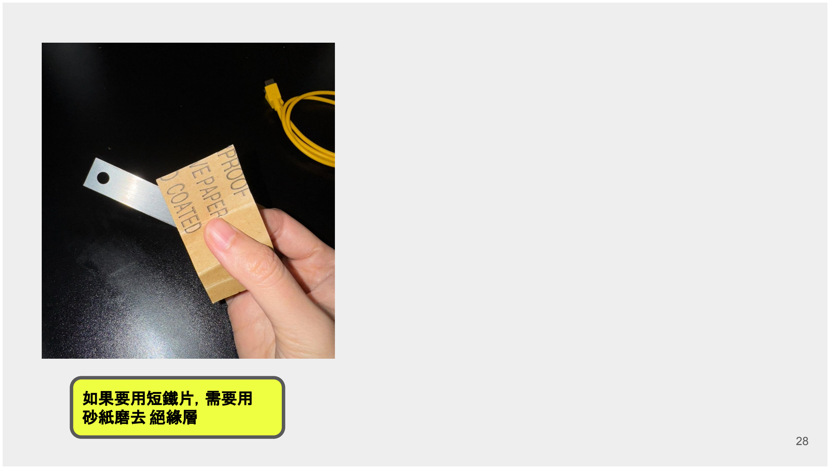
[picture p46: figure]
如果要用短鐵片，需要用 砂紙磨去 絕緣層
