JC-Project-IDEA/2025-26-Student-Workshop/Slides/JC Project IDEA - 202526 Software Installation (macOS)-20250903.pdf

Jockey Club Project IDEA

### 賽馬會科藝共融計劃

Inclusive Digital and Experimental Art

## Jockey Club Project IDEA Software Installation Guide (macOS)

Please Download the Following Software:

1. Arduino IDE
2. VCV Rack 2
3. MIDI Monitor

Software 1: Arduino IDE

Download Page: https://www.arduino.cc/en/software

1. Get the latest version (Arduino IDE 2.3.6) from the Downloads page. Select the suitable macOS option for your computer.

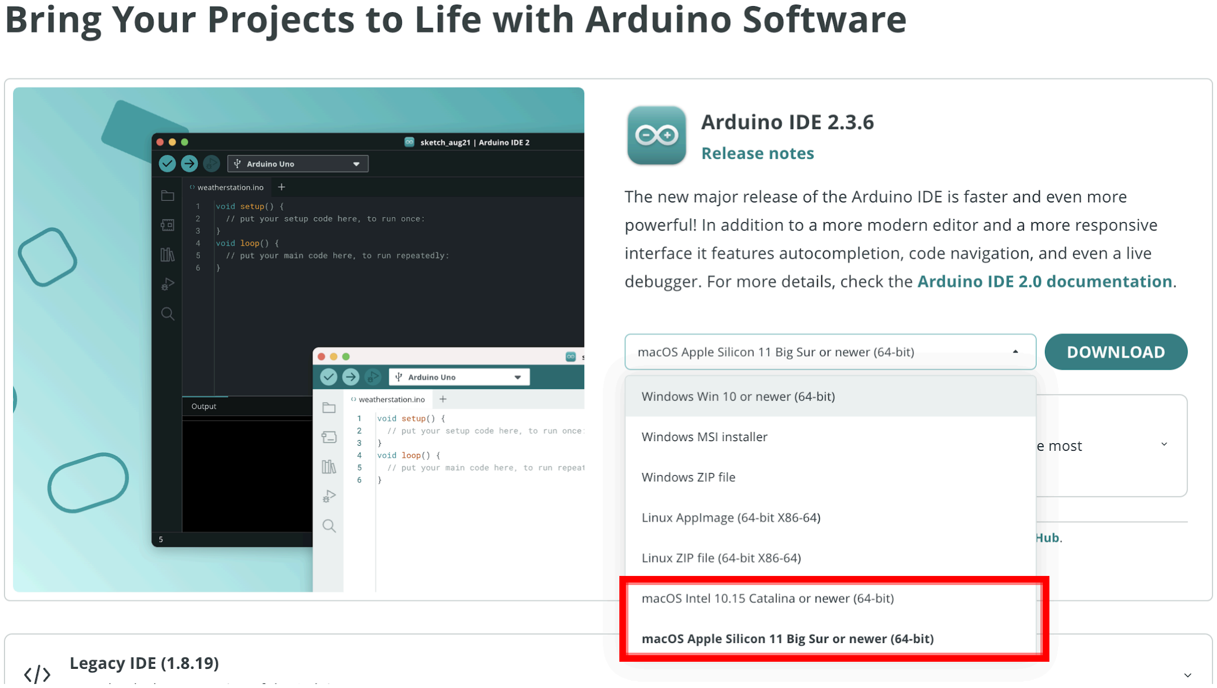
[picture p47: figure]
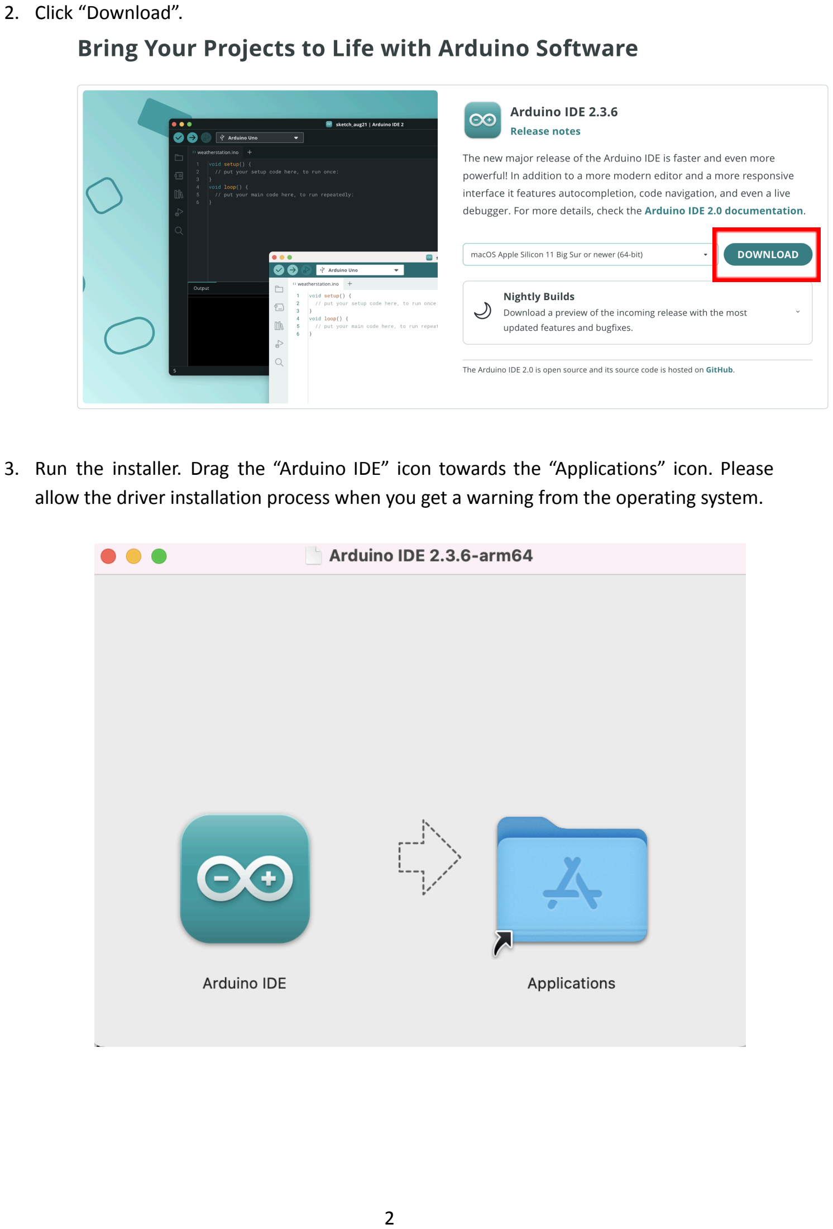
[picture p48: page 2]

2. Click “Download”.
3. Run the installer. Drag the “Arduino IDE” icon towards the “Applications” icon. Please allow the driver installation process when you get a warning from the operating system.

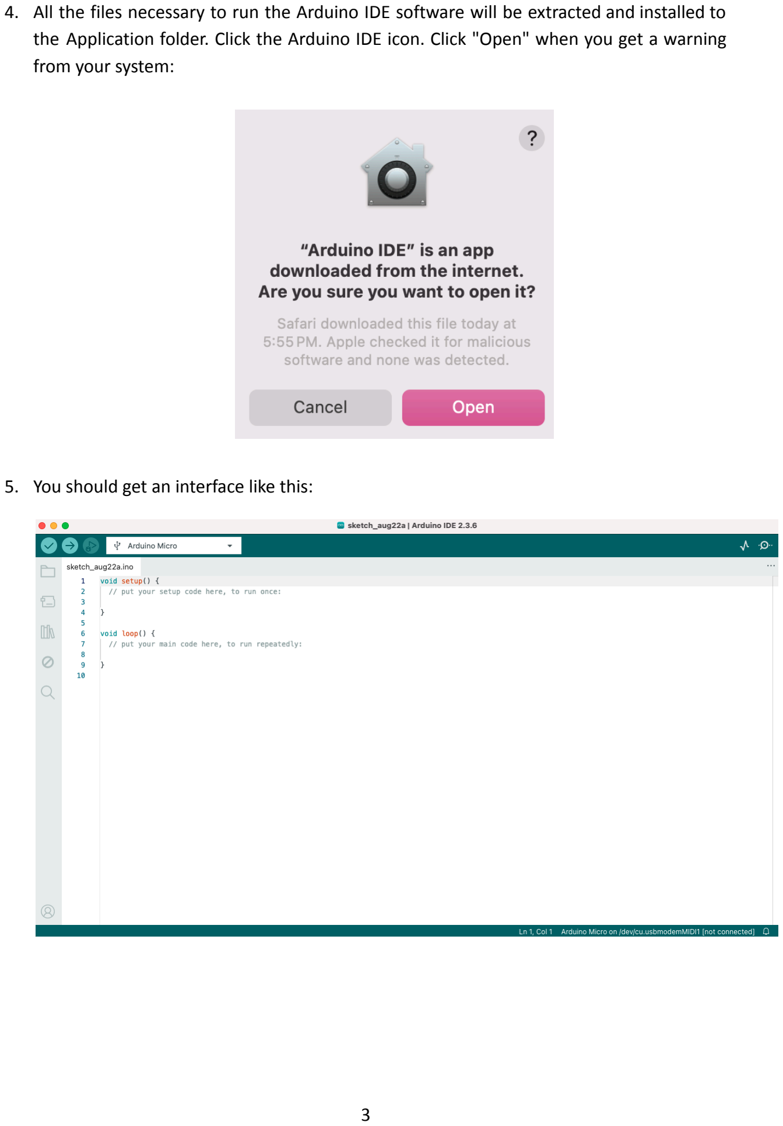
[picture p49: page 3]

4. All the files necessary to run the Arduino IDE software will be extracted and installed to the Application folder. Click the Arduino IDE icon. Click "Open" when you get a warning from your system:
5. You should get an interface like this:

Software 2: VCV Rack 2

Downloads Page: https://vcvrack.com/Rack#get

1. Get the latest version (2.6.4) from the Rack 2 Free section . Click “macOS”.

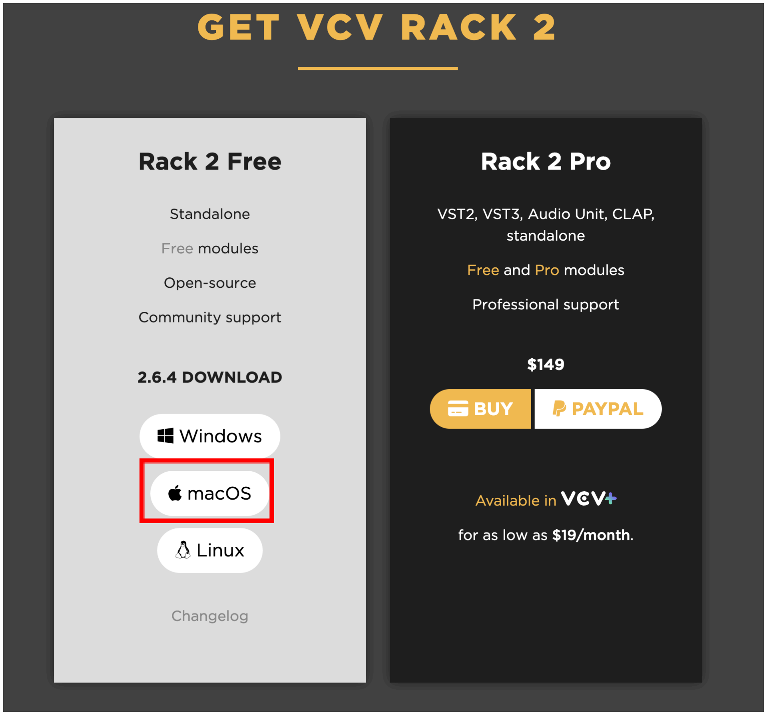
[picture p50: figure]
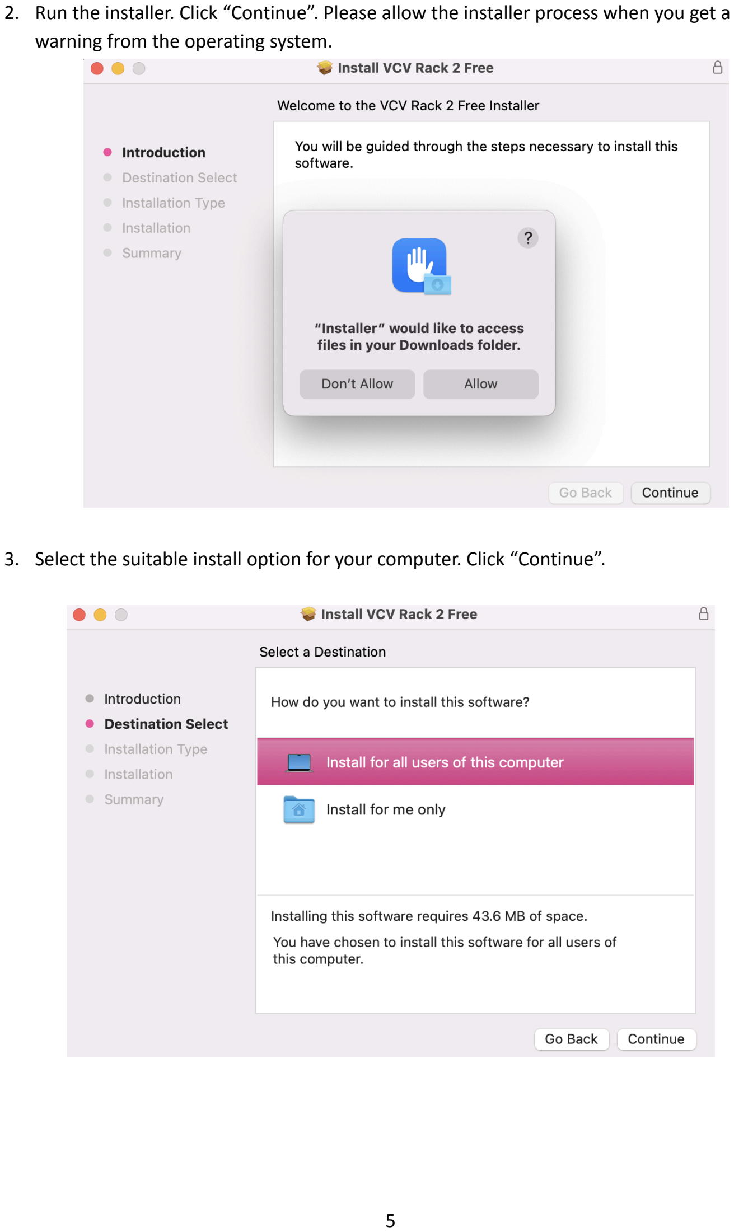
[picture p51: page 5]

2. Run the installer. Click “Continue”. Please allow the installer process when you get a warning from the operating system.
3. Select the suitable install option for your computer. Click “Continue”.

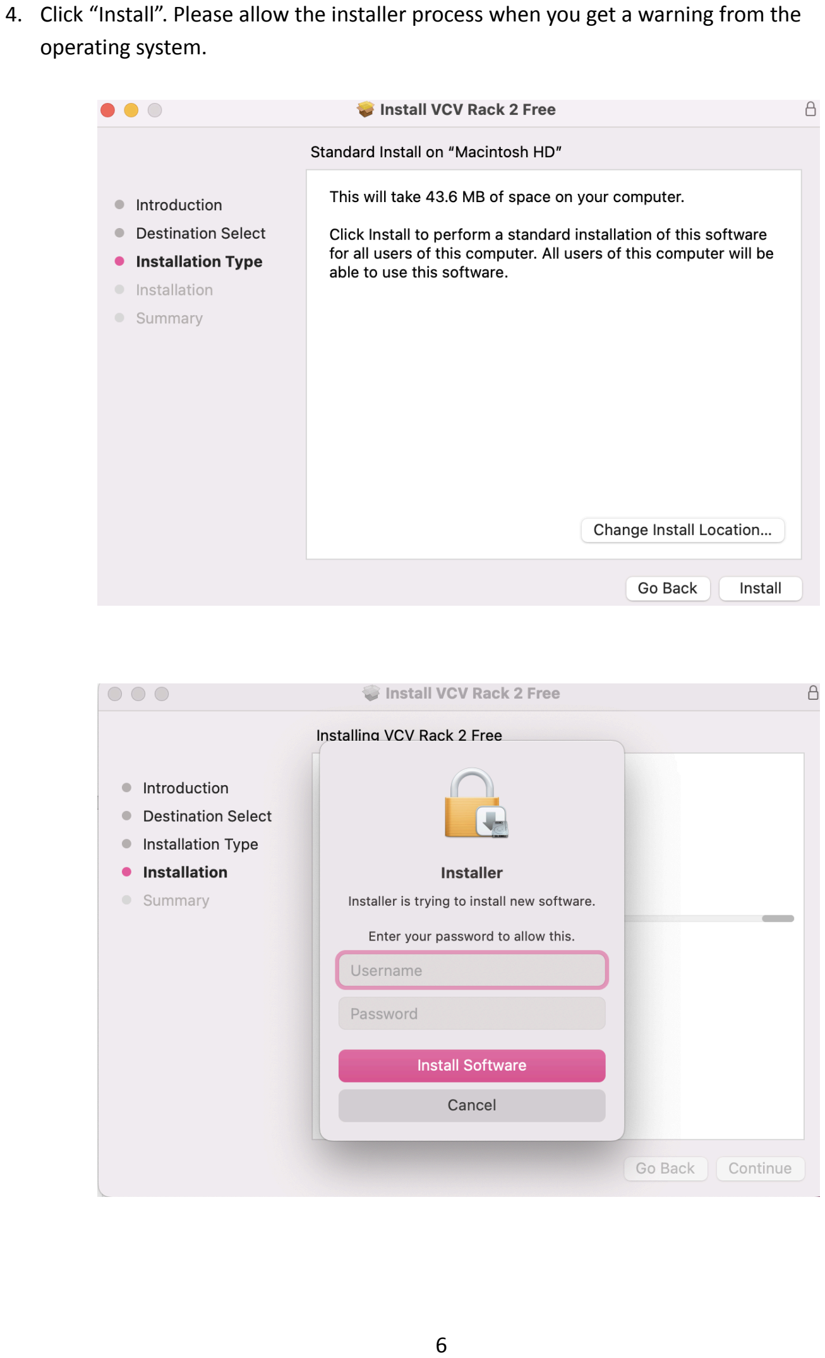
[picture p52: page 6]

4. Click “Install”. Please allow the installer process when you get a warning from the operating system.

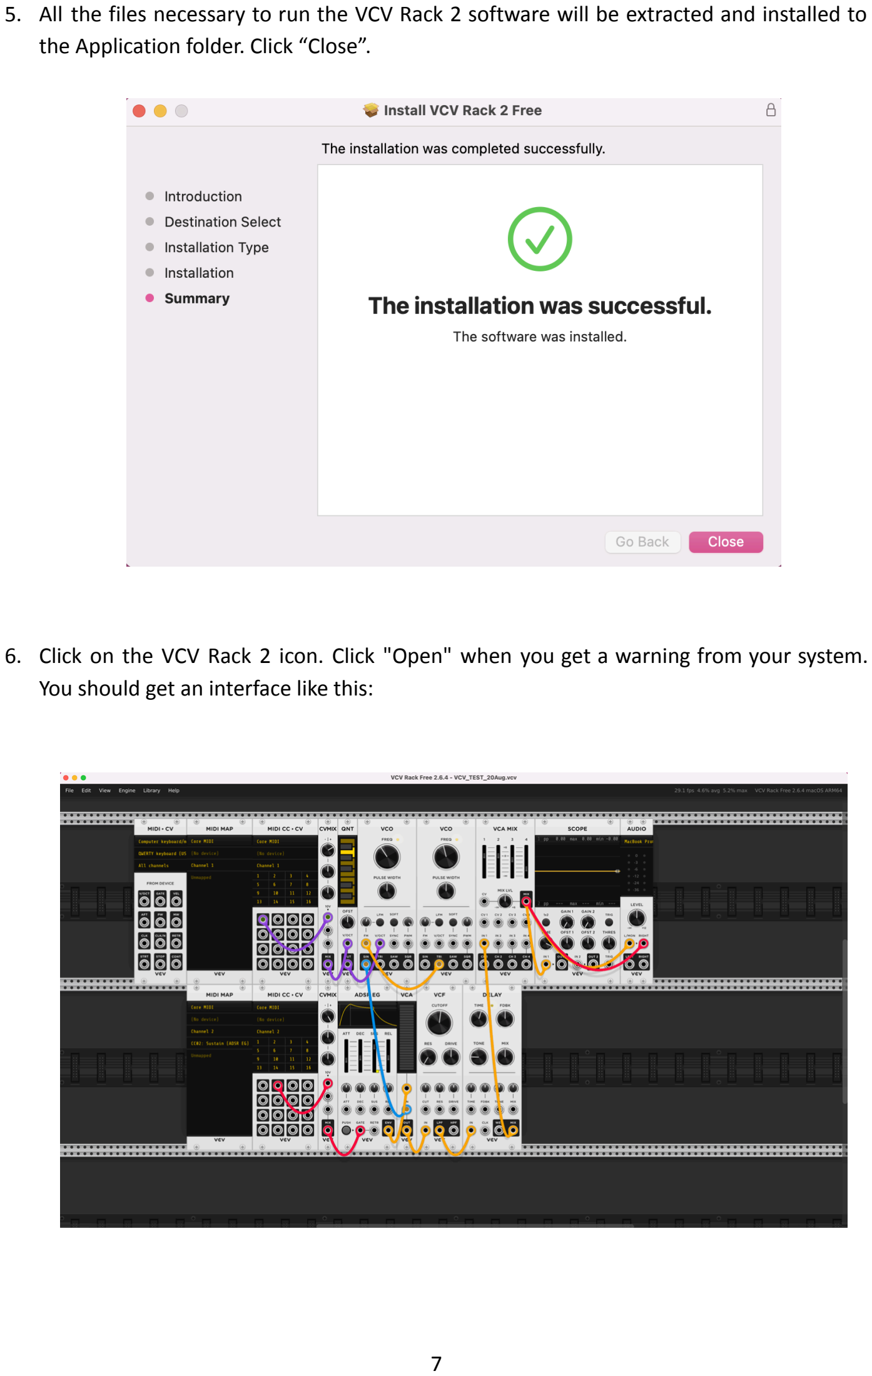
[picture p53: page 7]

5. All the files necessary to run the VCV Rack 2 software will be extracted and installed to the Application folder. Click “Close”.
6. Click on the VCV Rack 2 icon. Click "Open" when you get a warning from your system. You should get an interface like this:

Software 3: MIDI Monitor

Downloads Page: https://www.snoize.com/MIDIMonitor/

1. Get the latest version (1.5.4) from the MIDI Monitor Section. Click Download.

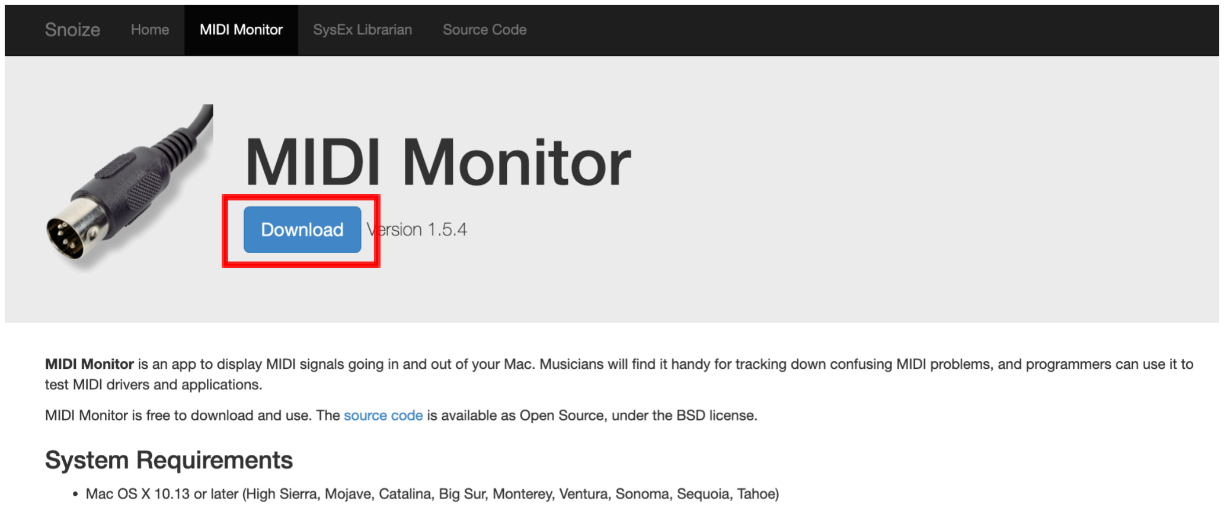
[picture p54: figure]

2. Run the installer. Drag the “MIDI Monitor” icon towards the “Applications” icon. Please allow the driver installation process when you get a warning from the operating system.

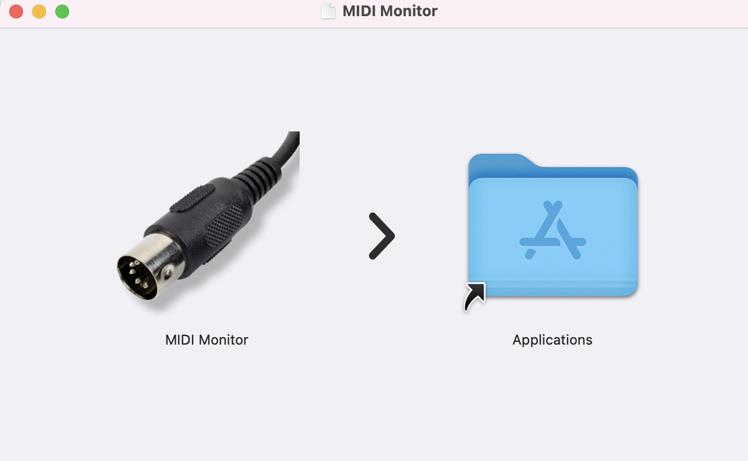
[picture p55: figure]

3. All the files necessary to run the MIDI Monitor software will be extracted and installed to the Application folder. Click the MIDI Monitor icon. Click "Open" when you get a warning from your system:
4. Click "Continue".

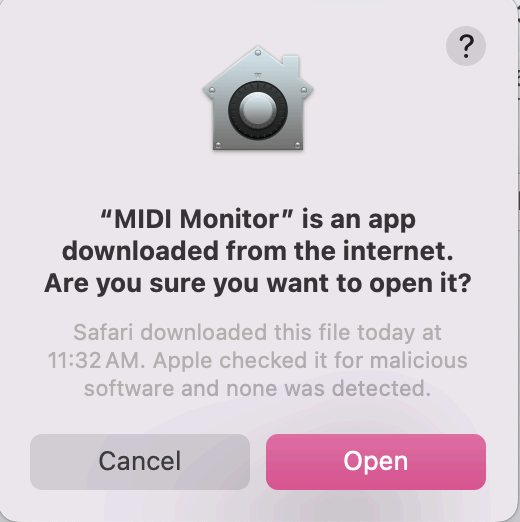
[picture p56: figure]
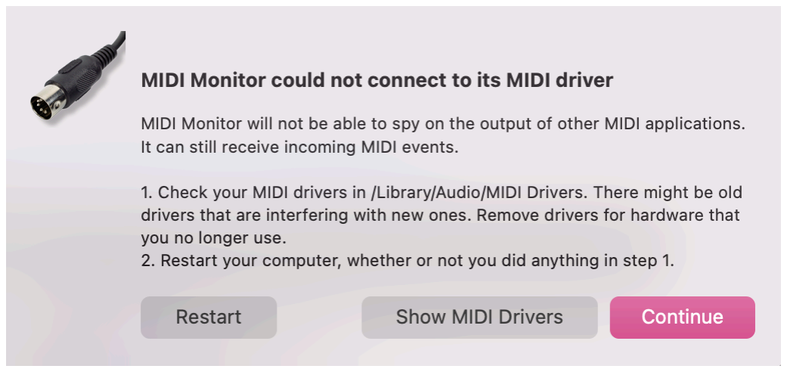
[picture p57: figure]

5. You should get an interface like this:

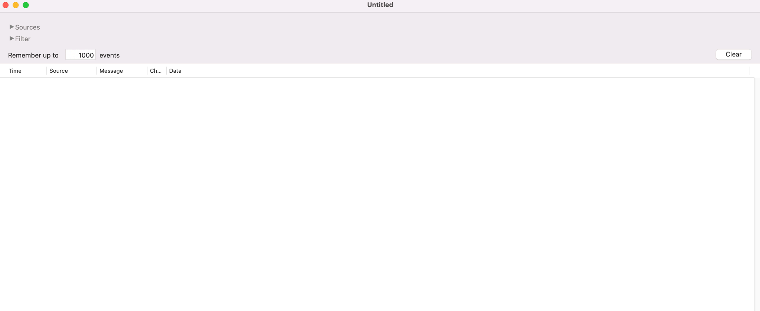
[picture p58: figure]
