JC-Project-IDEA/2025-26-Student-Workshop/Slides/JC Project IDEA - 202526 Software Installation (Windows)-20250909.pdf

Jockey Club Project IDEA

### 賽馬會科藝共融計劃

Inclusive Digital and Experimental Art

## Jockey Club Project IDEA Software Installation Guide (Windows)

Please Download the Following Software:

1. Arduino IDE
2. VCV Rack 2
3. MIDI Ox

Software 1: Arduino IDE
Downloads Page: https://www.arduino.cc/en/software
1. Get the latest version (Arduino IDE 2.3.6) from the Downloads page. Select the suitable Windows option for your computer.

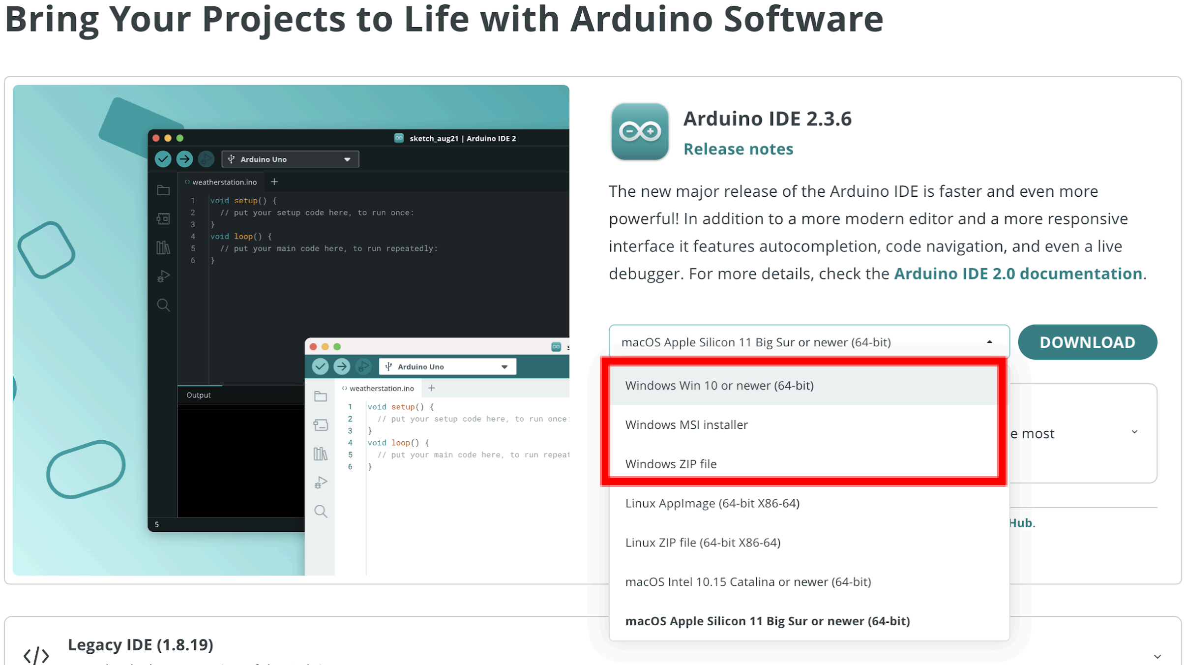
[picture p59: figure]
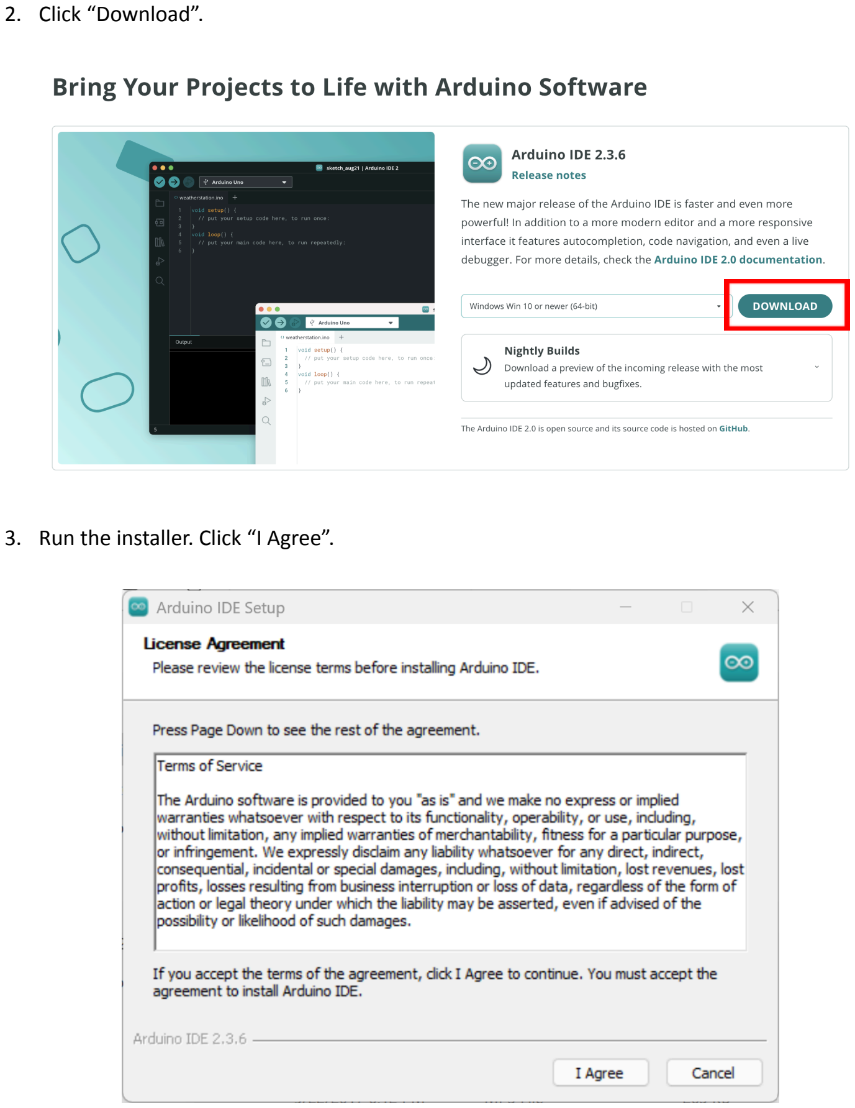
[picture p60: page 2]

2. Click “Download”.
3. Run the installer. Click “I Agree”.

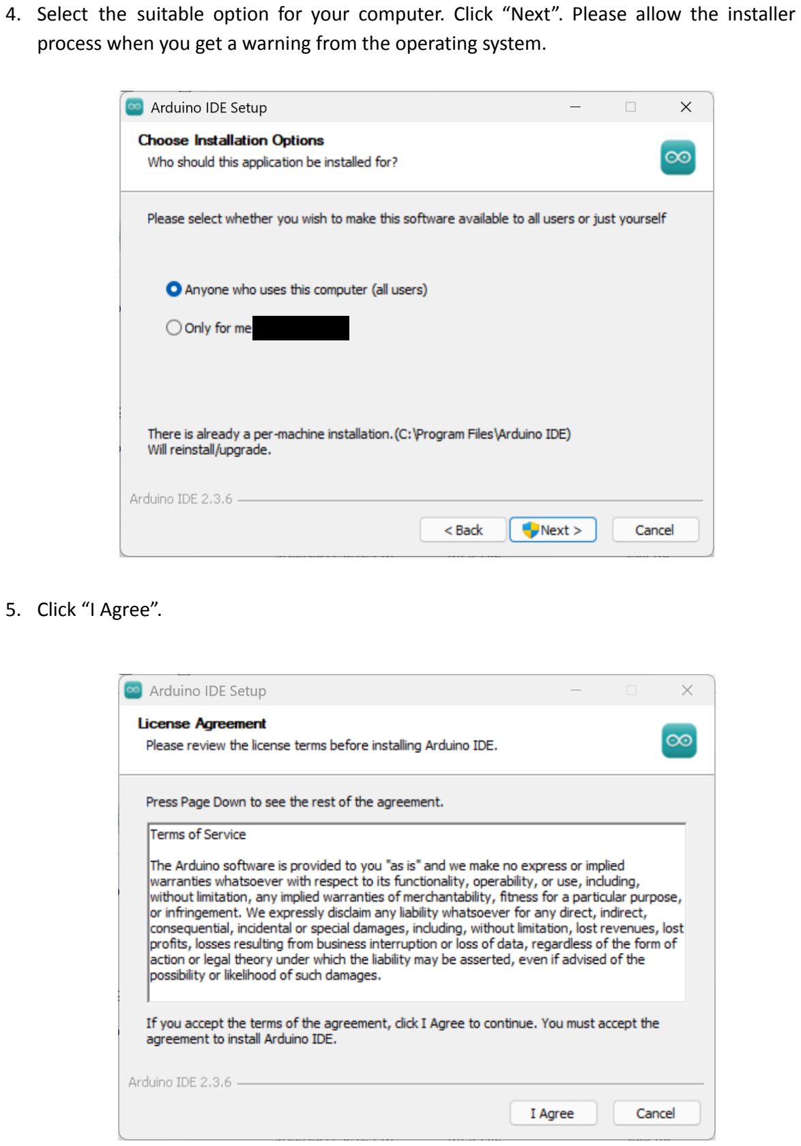
[picture p61: page 3]

4. Select the suitable option for your computer. Click “Next”. Please allow the installer process when you get a warning from the operating system.
5. Click “I Agree”.

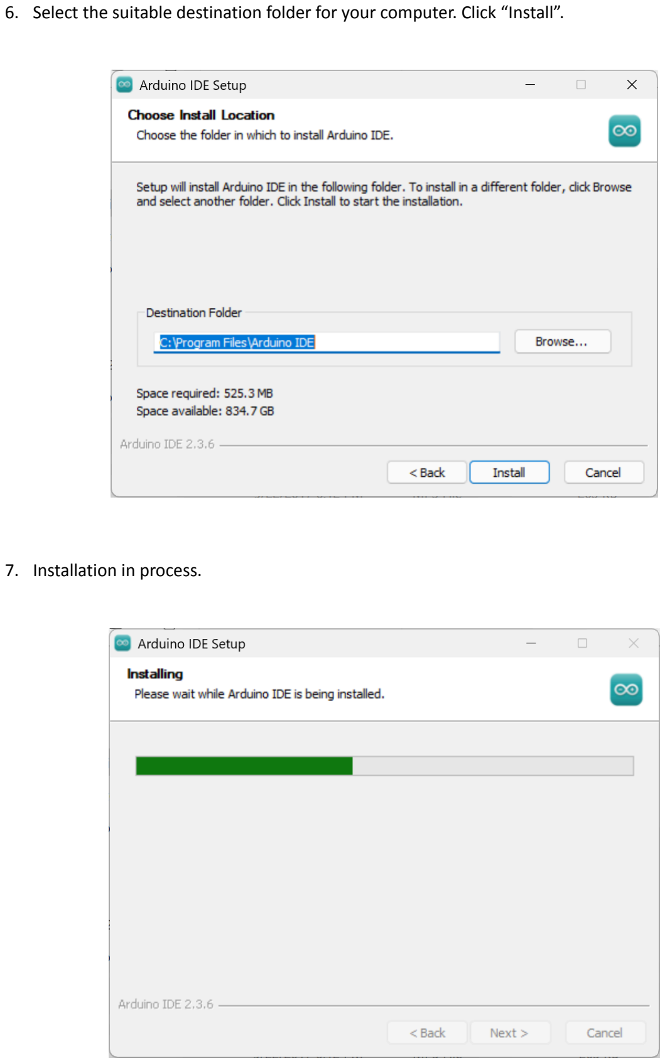
[picture p62: page 4]

6. Select the suitable destination folder for your computer. Click “Install”.
7. Installation in process.

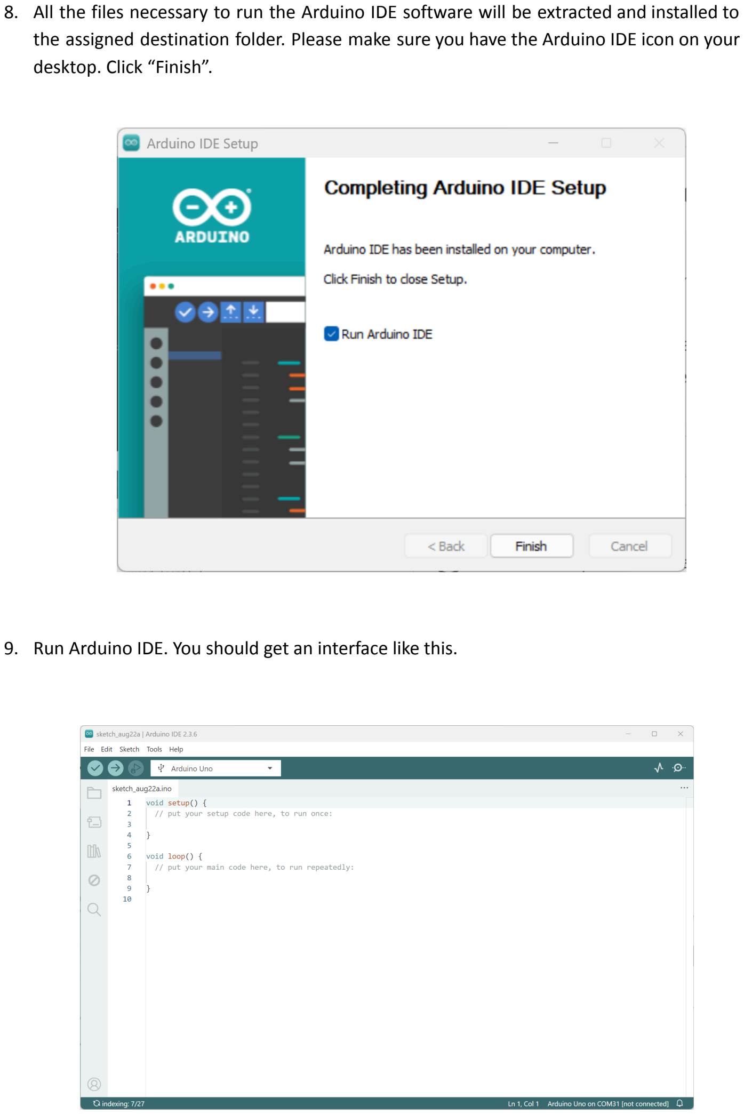
[picture p63: page 5]

8. All the files necessary to run the Arduino IDE software will be extracted and installed to the assigned destination folder. Please make sure you have the Arduino IDE icon on your desktop. Click “Finish”.
9. Run Arduino IDE. You should get an interface like this.

Software 2: VCV Rack 2
Downloads Page: https://vcvrack.com/Rack#get
1. Get the latest version (2.6.4) from the Rack 2 Free section . Click “Windows”.

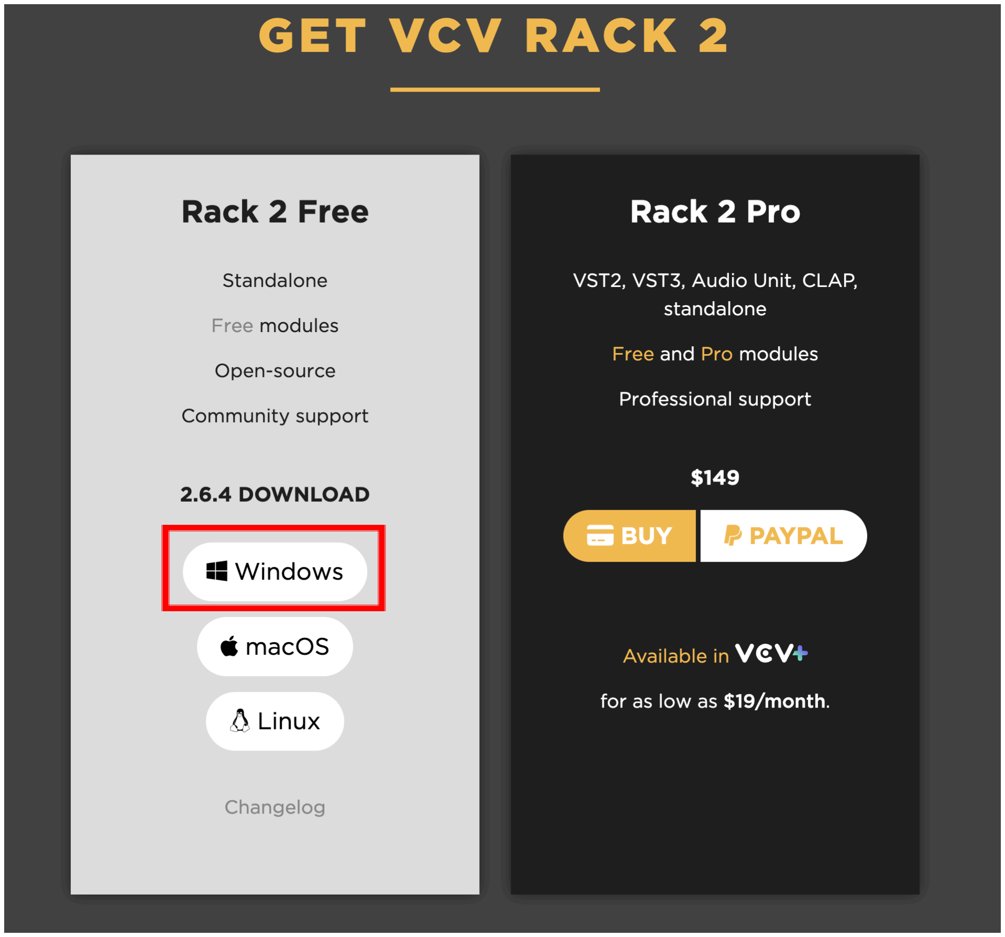
[picture p64: figure]
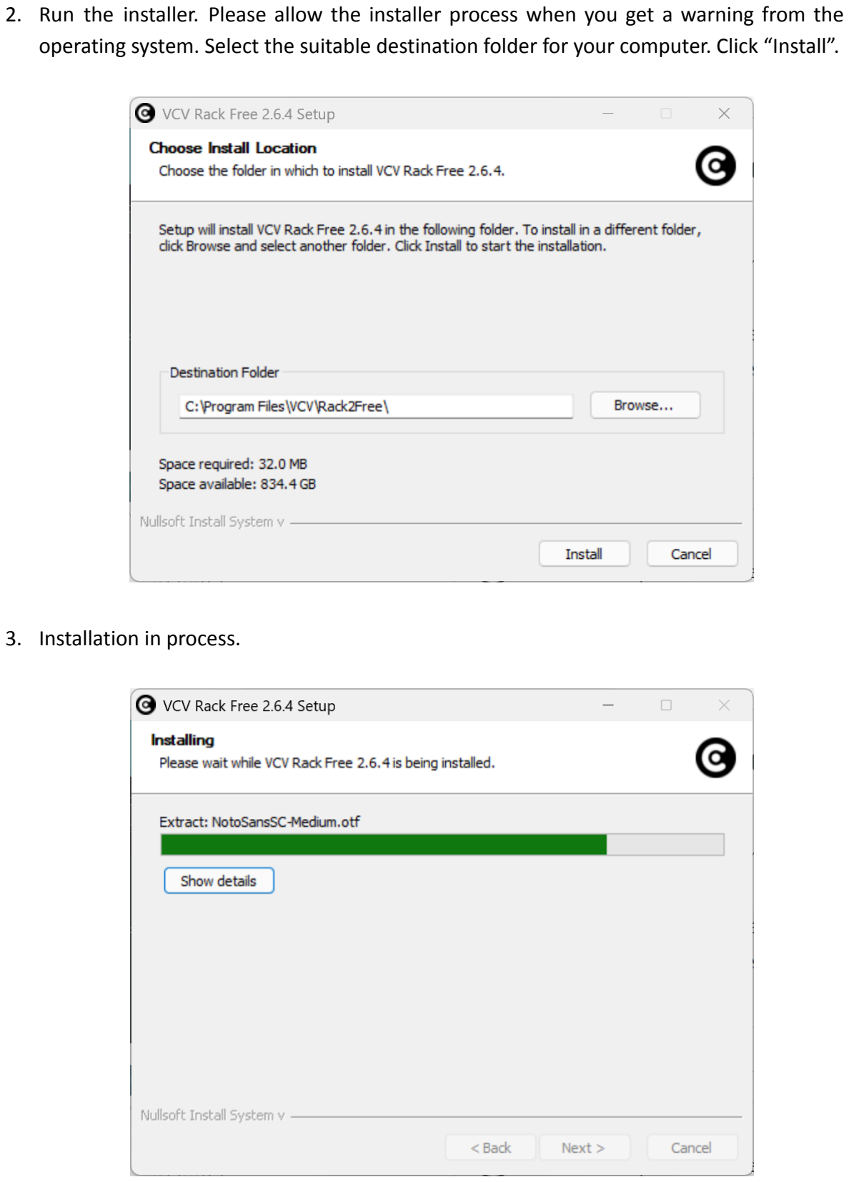
[picture p65: page 7]

2. Run the installer. Please allow the installer process when you get a warning from the operating system. Select the suitable destination folder for your computer. Click “Install”.
3. Installation in process.

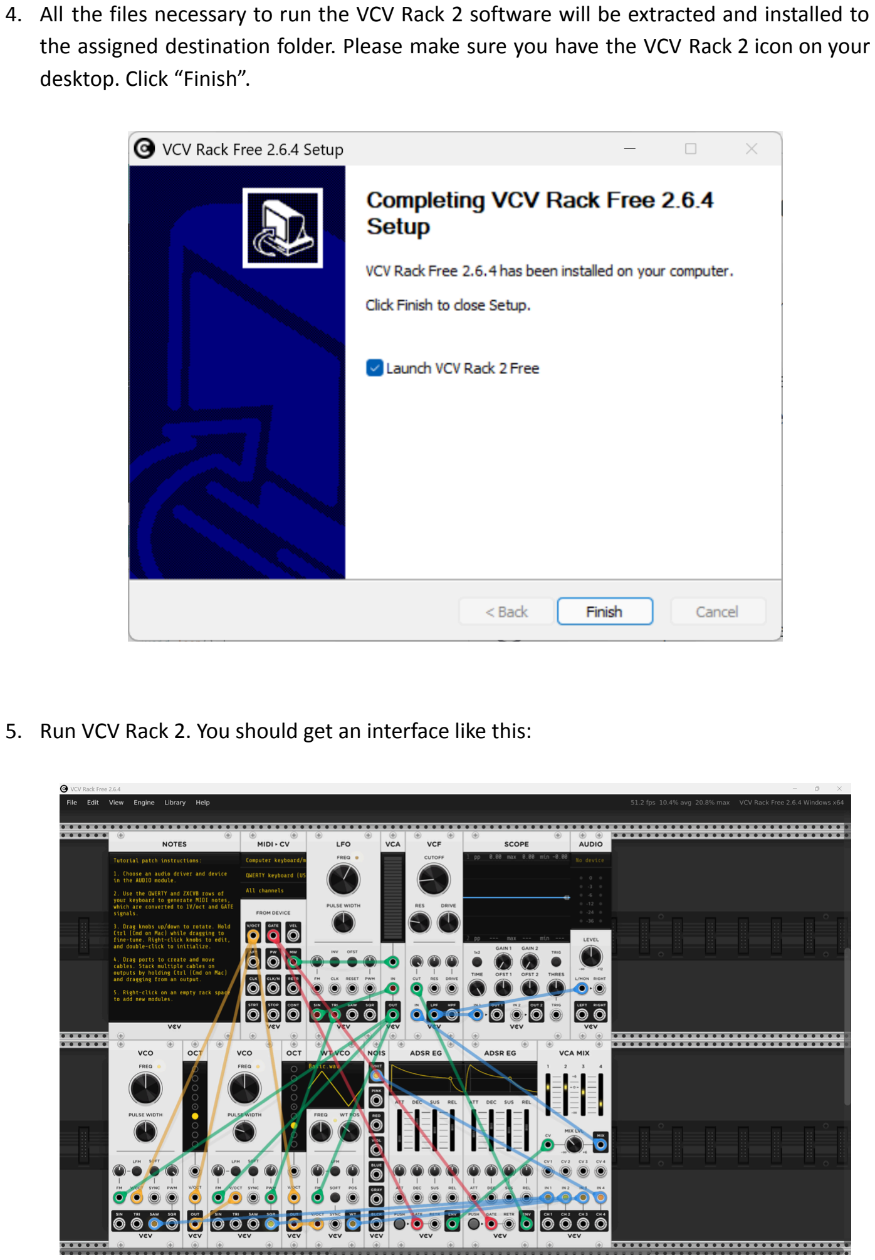
[picture p66: page 8]

4. All the files necessary to run the VCV Rack 2 software will be extracted and installed to the assigned destination folder. Please make sure you have the VCV Rack 2 icon on your desktop. Click “Finish”.
5. Run VCV Rack 2. You should get an interface like this:

Software 3: MIDI Ox

Downloads Page: www.midiox.com

1. Visit www.midiox.com. Please allow your Web Browser (Chrome) to continue to access the site.

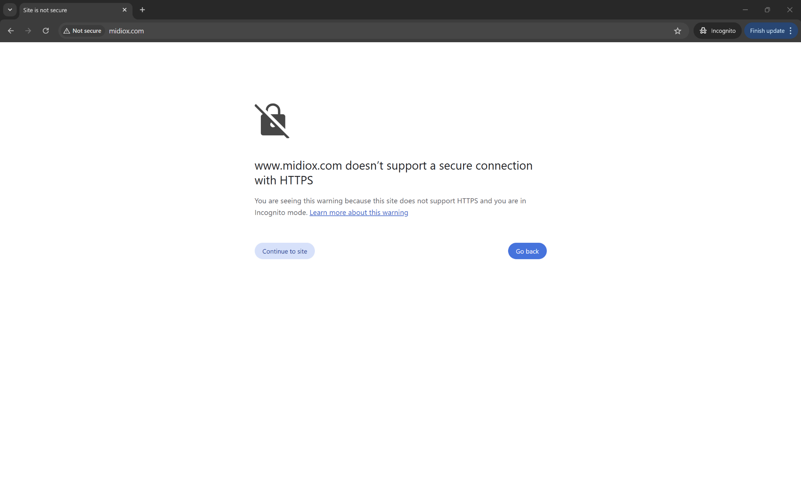
[picture p67: figure]

2. Click “Download: MIDI-OX 7.0.2”.

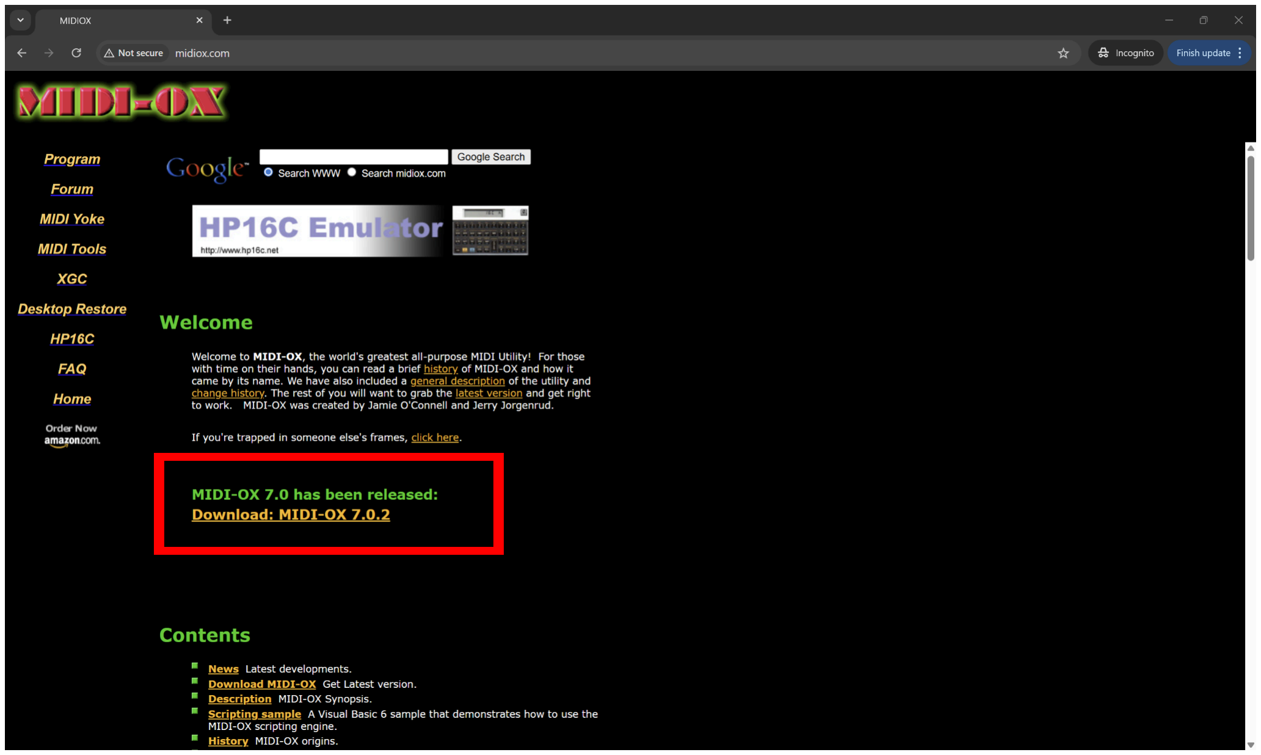
[picture p68: figure]

3. Click “Download”.

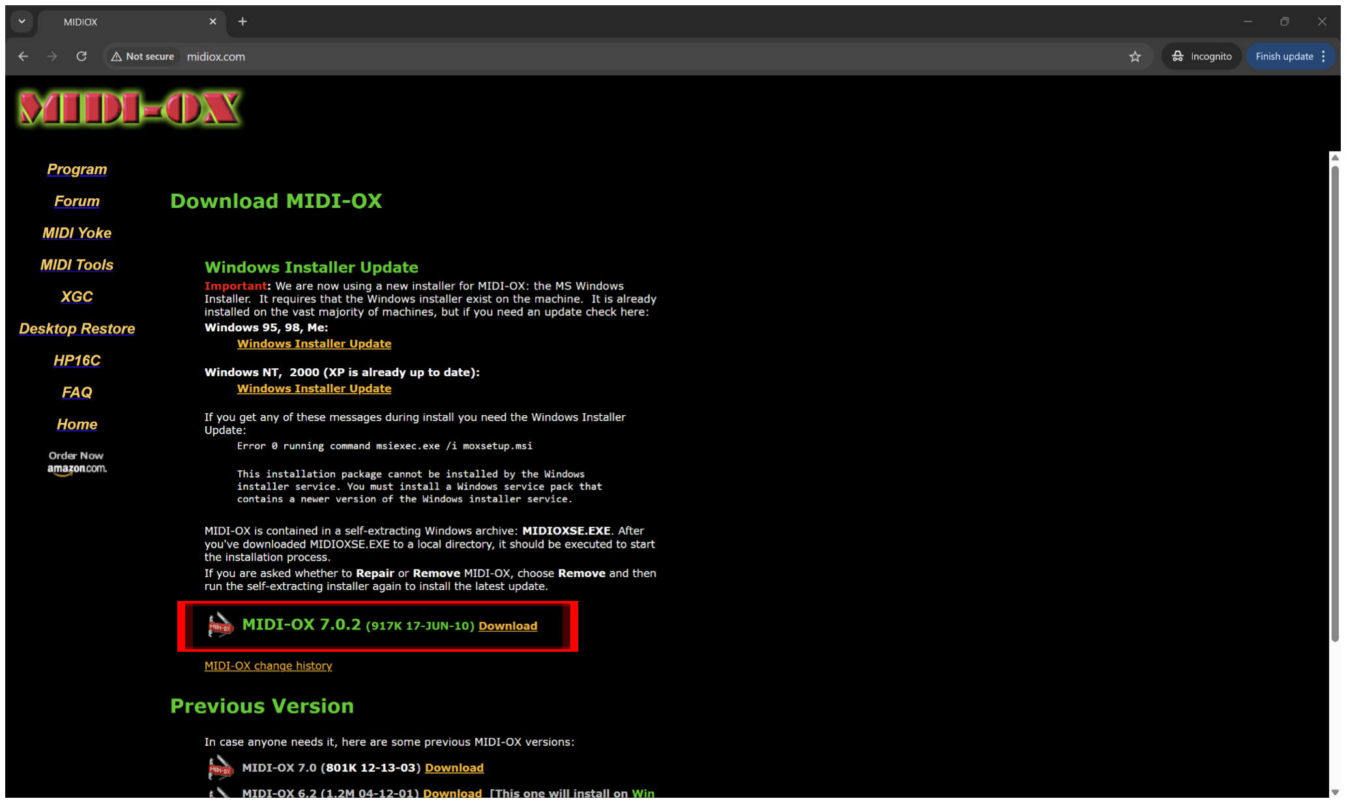
[picture p69: figure]

4. Run the Installer. Please allow the installer process when you get a warning from the operating system. Click “Setup”.

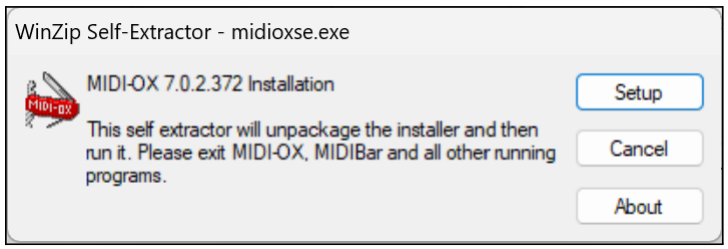
[picture p70: figure]

5. Click “Next”.

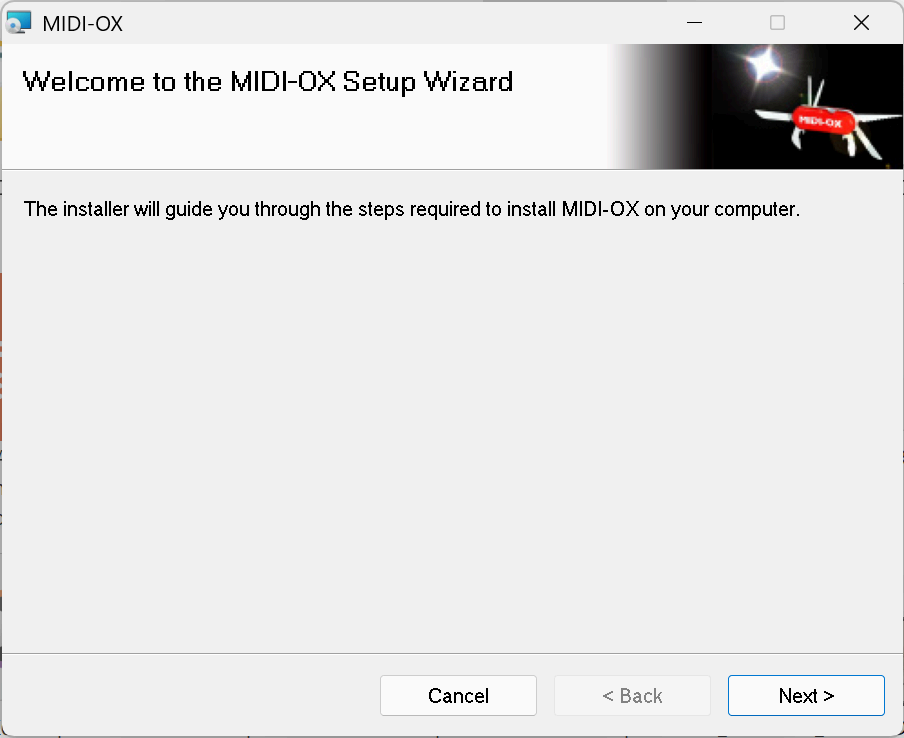
[picture p71: figure]

6. Select “I Agree” and click “Next”.

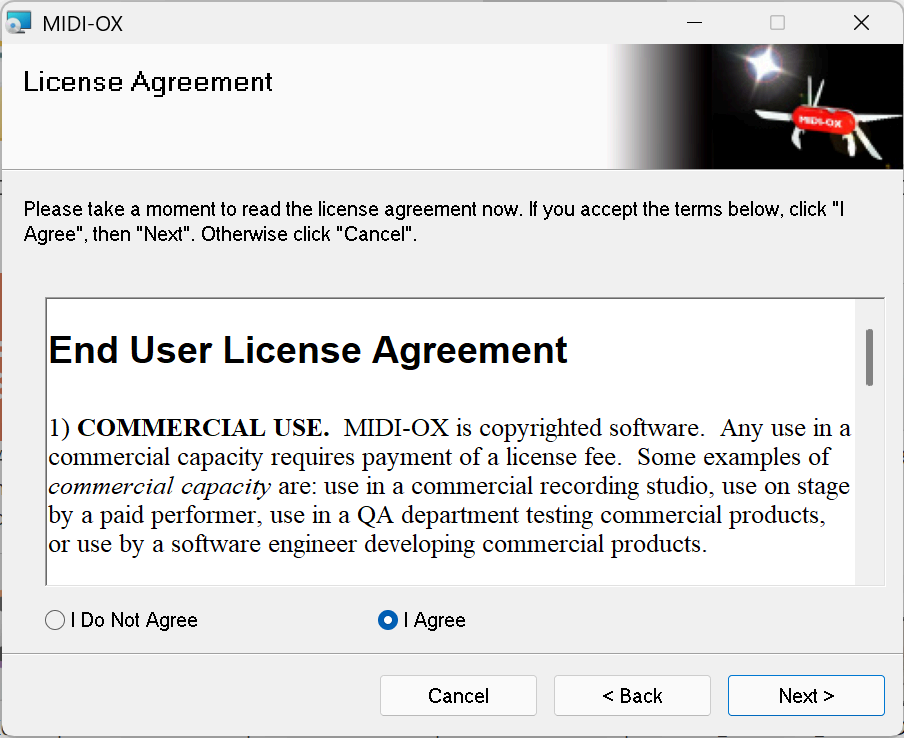
[picture p72: figure]

7. Select “Personal Use: …” and click “Next”.

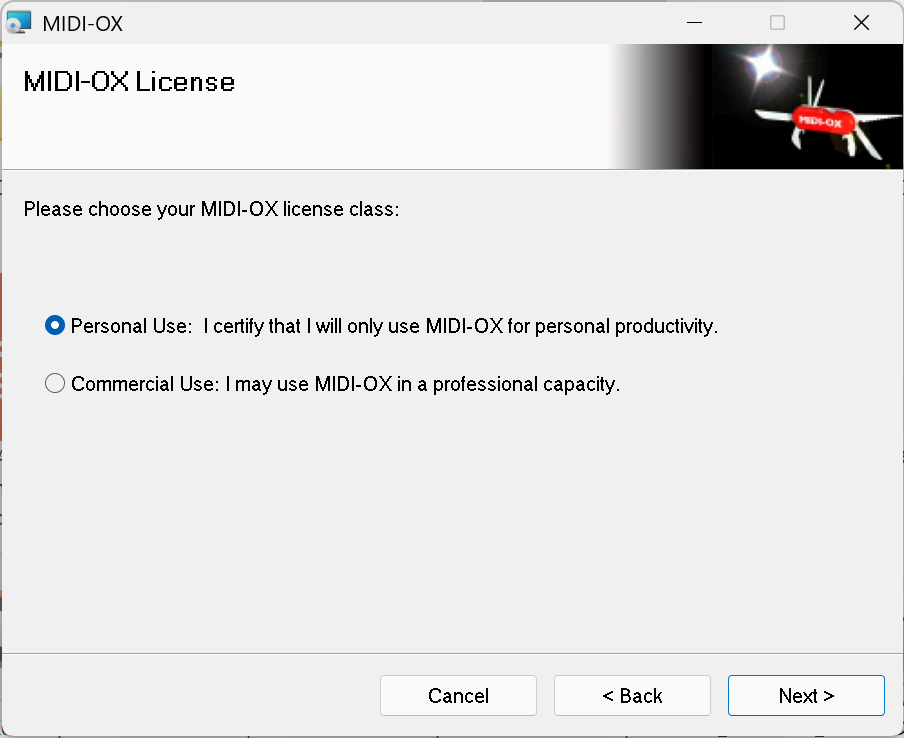
[picture p73: figure]

8. Write a suitable name at the UserName input box for your computer and click “Next”.

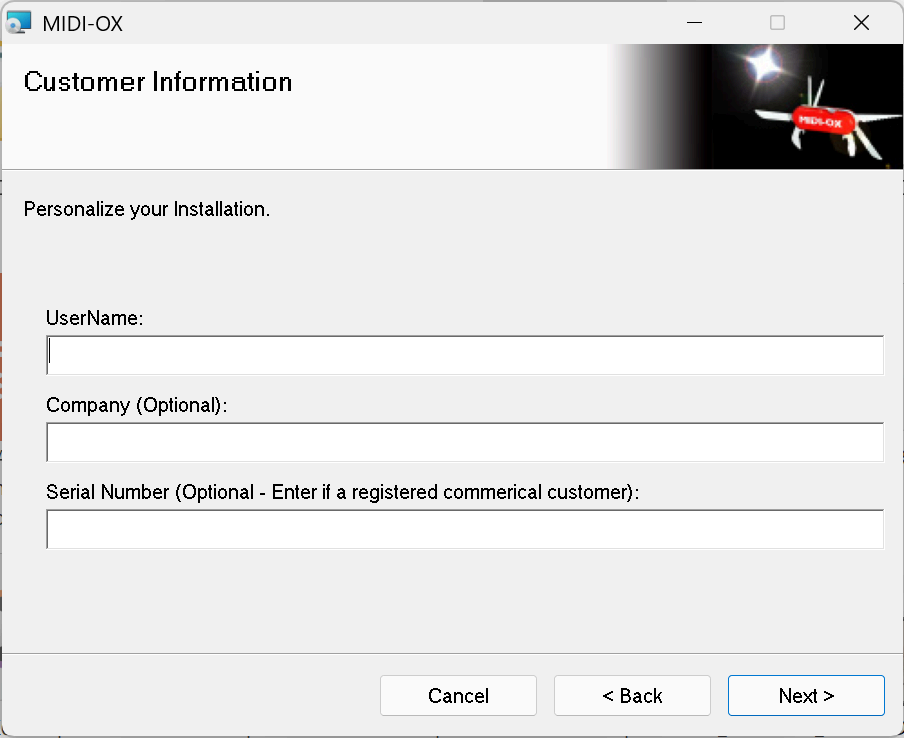
[picture p74: figure]

9. Select a suitable destination folder and user option for your computer. Click “Next”.
10. Click “Next”.

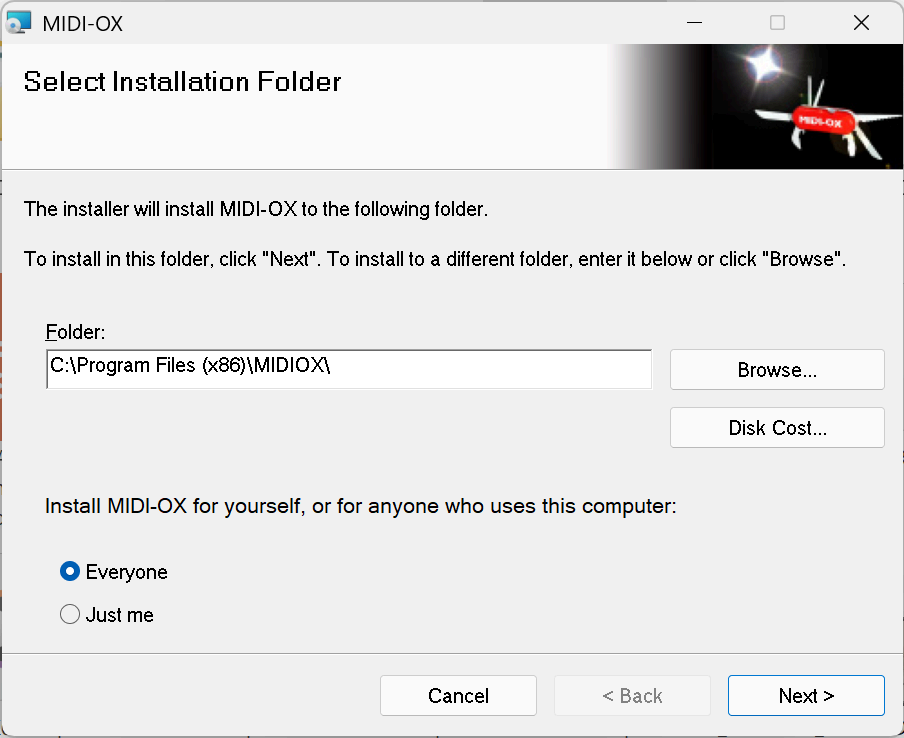
[picture p75: figure]
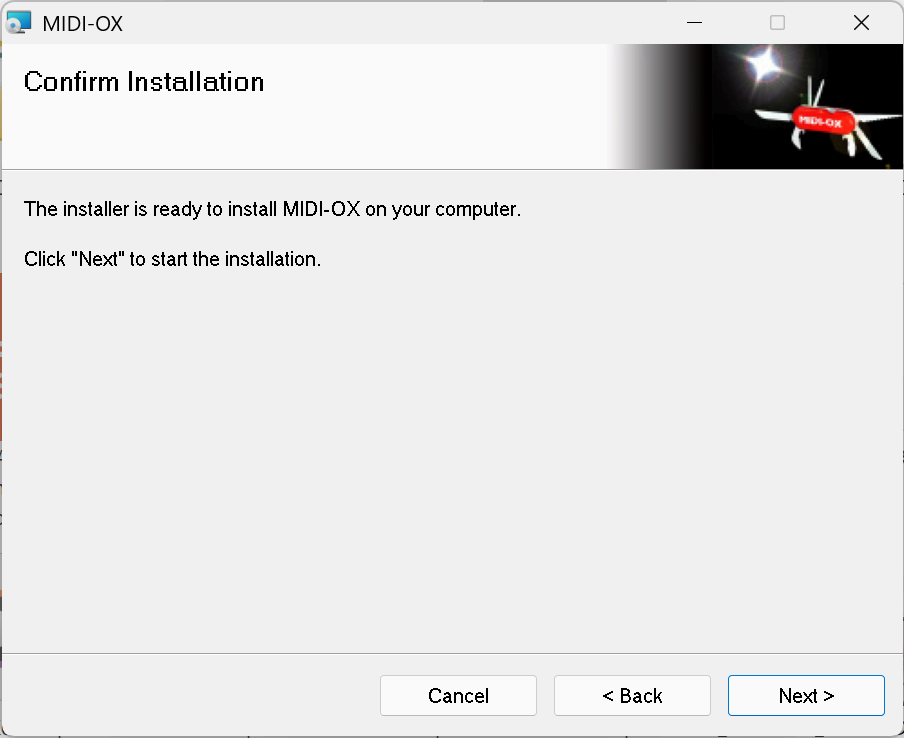
[picture p76: figure]
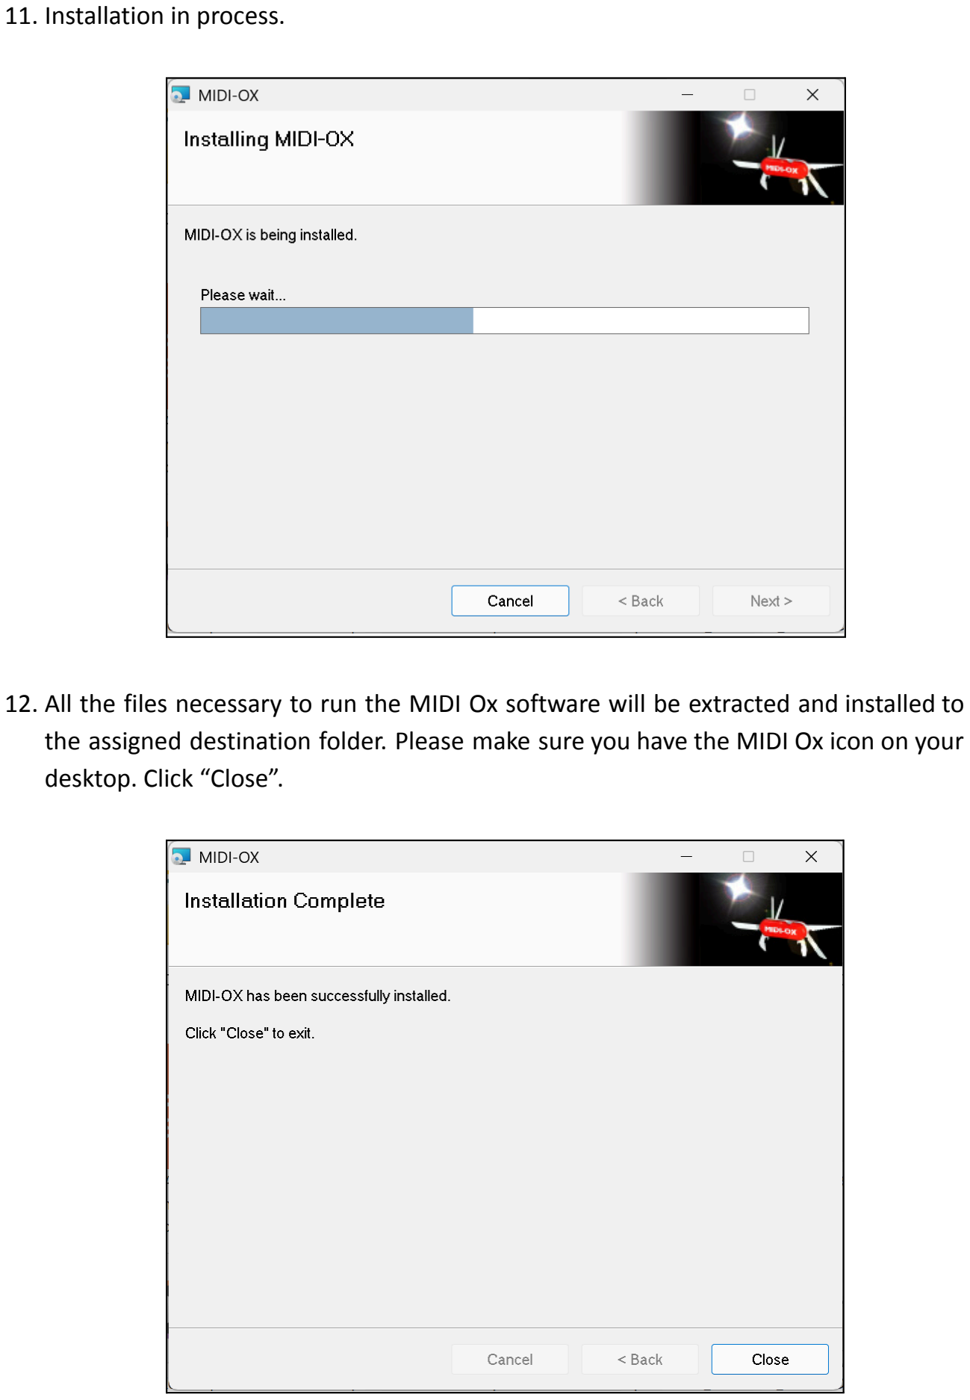
[picture p77: page 14]

11. Installation in process.
12. All the files necessary to run the MIDI Ox software will be extracted and installed to the assigned destination folder. Please make sure you have the MIDI Ox icon on your desktop. Click “Close”.

13. Run MIDI Ox. Please allow your computer to run the software if you get a warning. Click “OK” if you get this window.

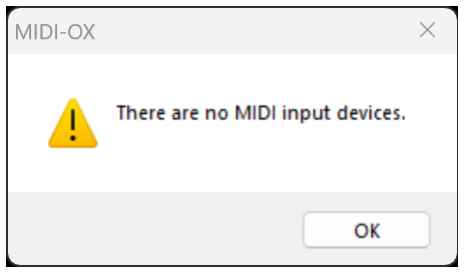
[picture p78: figure]

14. You should get an interface like this.
